SamsonTaxon/openmote-landing/assets/esp32-devkitc.webp

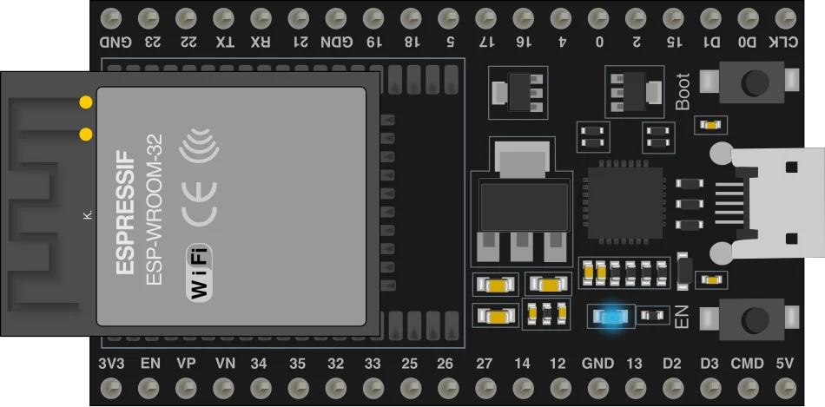
assets/esp32-devkitc.webp
