SamsonTaxon/openmote-landing/assets/photo-cutouts/product-01.png

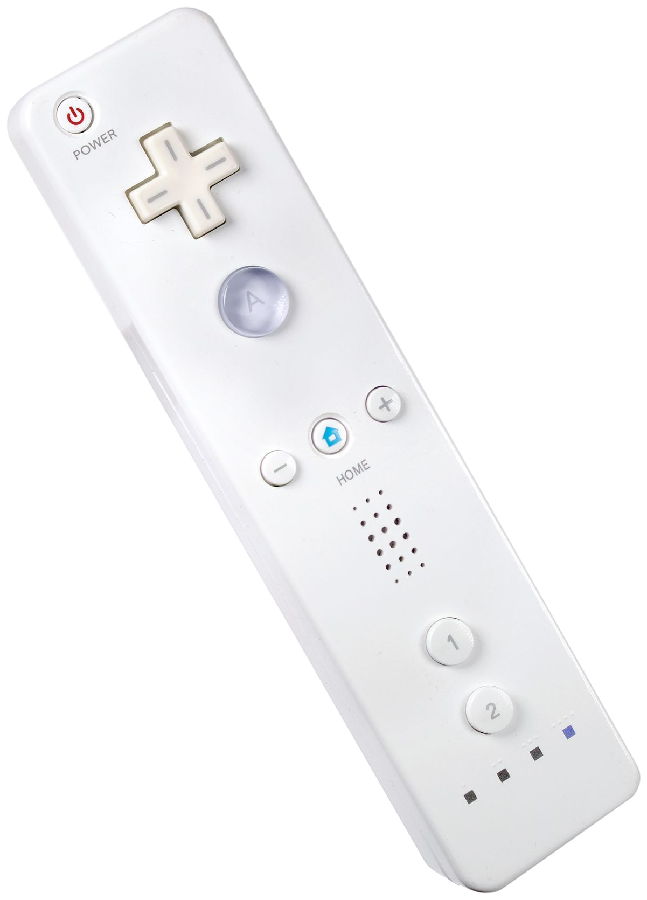
assets/photo-cutouts/product-01.png
