SamsonTaxon/openmote-landing/assets/photo-cutouts/product-02.png

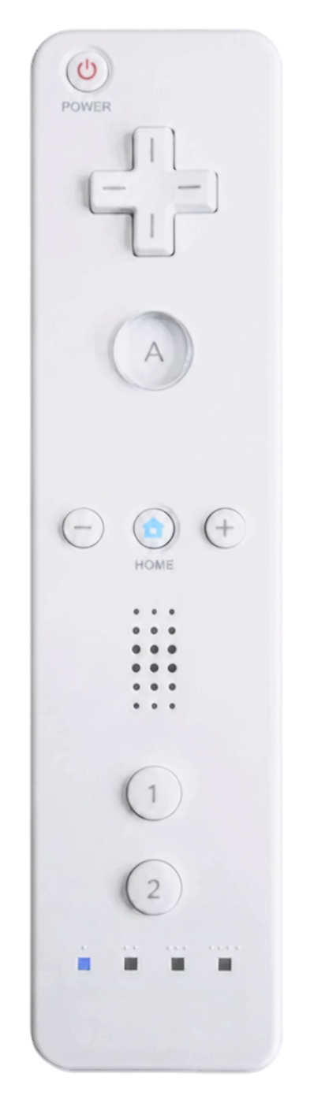
assets/photo-cutouts/product-02.png
