SamsonTaxon/openmote-landing/assets/photo-cutouts/product-03.png

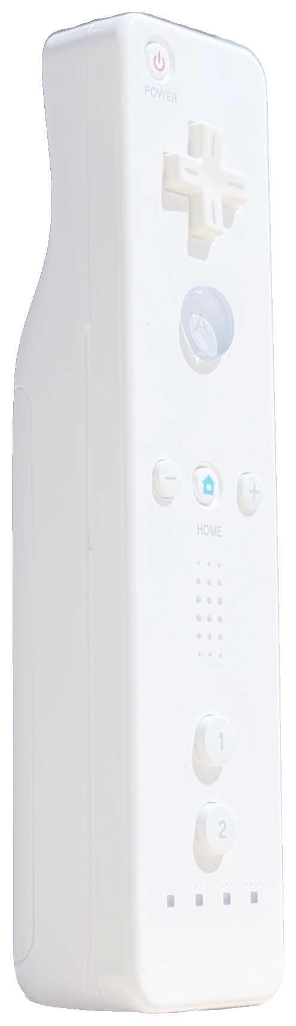
assets/photo-cutouts/product-03.png
