SamsonTaxon/openmote-landing/assets/photo-cutouts/product-03.webp

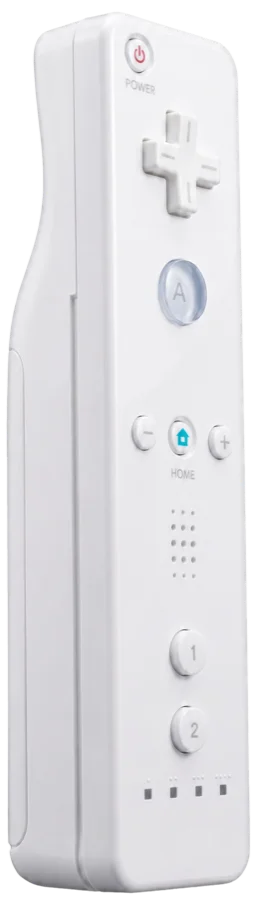
assets/photo-cutouts/product-03.webp
