SamsonTaxon/openmote-landing/assets/photo-cutouts/product-09-web.webp

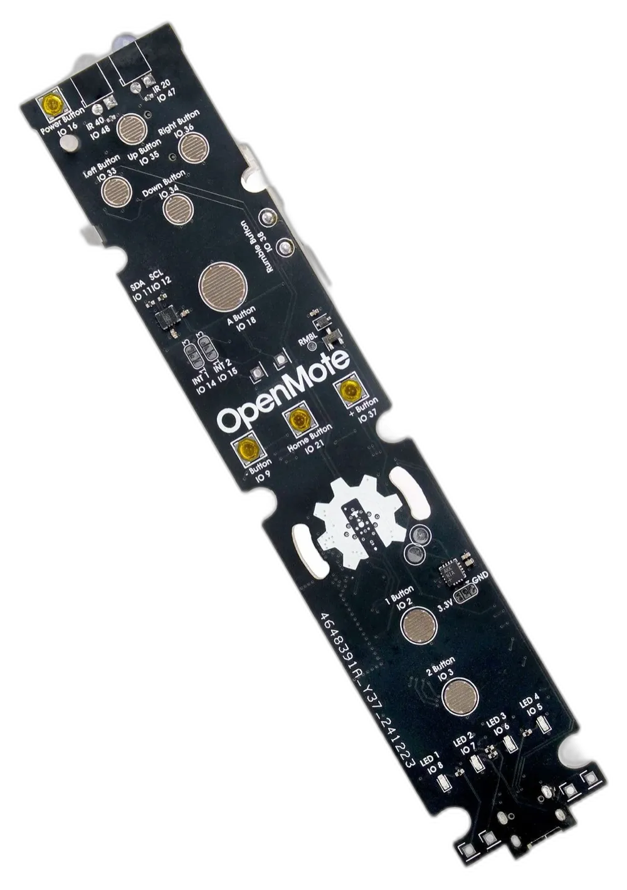
assets/photo-cutouts/product-09-web.webp
