SamsonTaxon/openmote-landing/assets/platform-circuitpython.webp

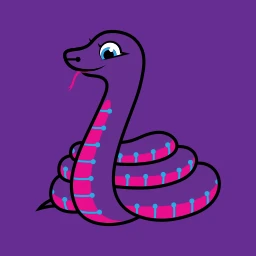
assets/platform-circuitpython.webp
