SamsonTaxon/openmote-landing/img/hero-remote-a.webp

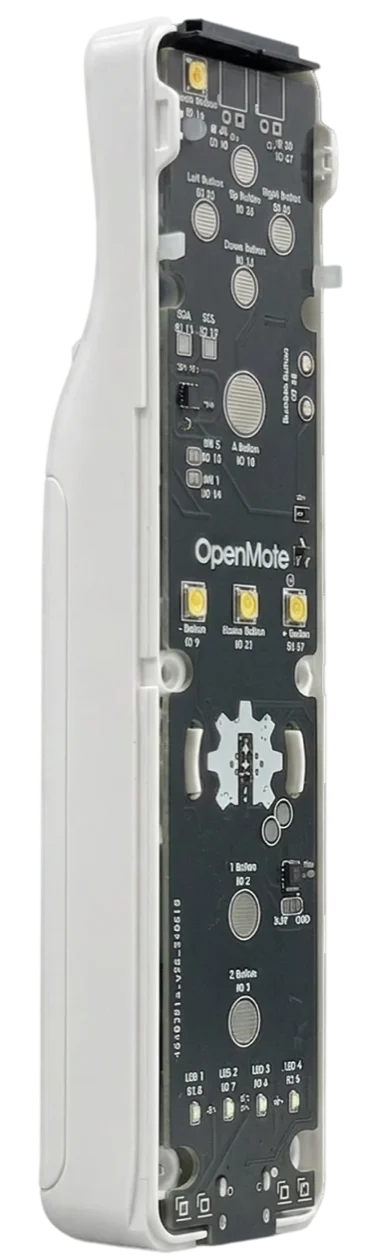
img/hero-remote-a.webp
