SamsonTaxon/openmote-landing/img/hero-remote-b.webp

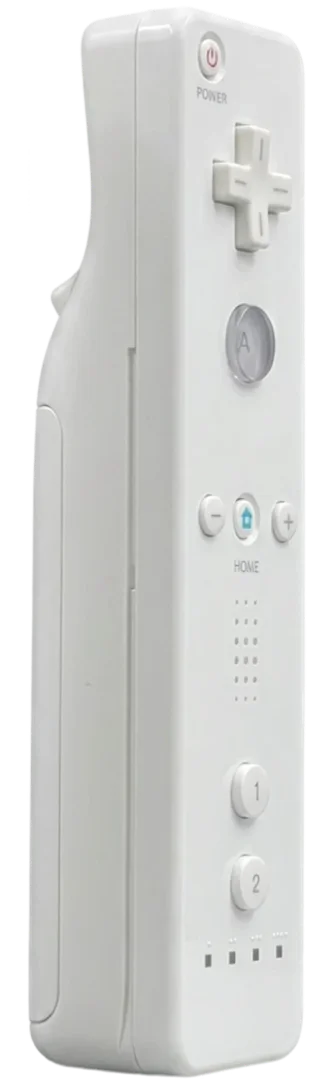
img/hero-remote-b.webp
