SamsonTaxon/openmote-landing/img/hero-remotes.webp

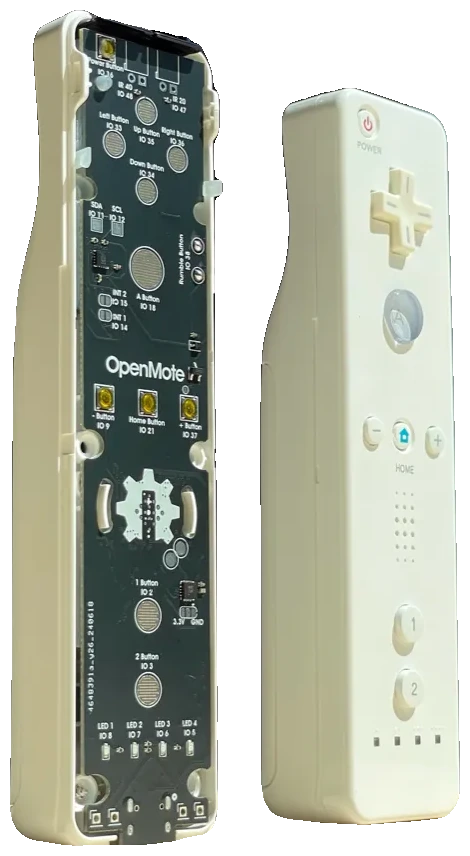
img/hero-remotes.webp
