SamsonTaxon/openmote-landing/img/hero.webp

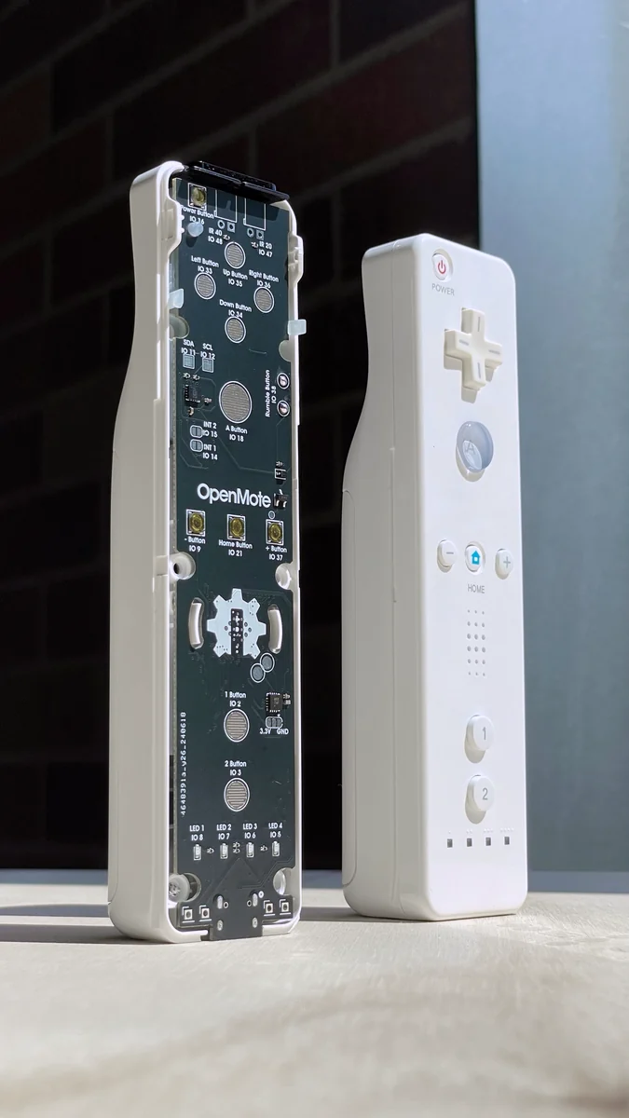
img/hero.webp
