SamsonTaxon/openmote-landing/img/og-openmote.jpg

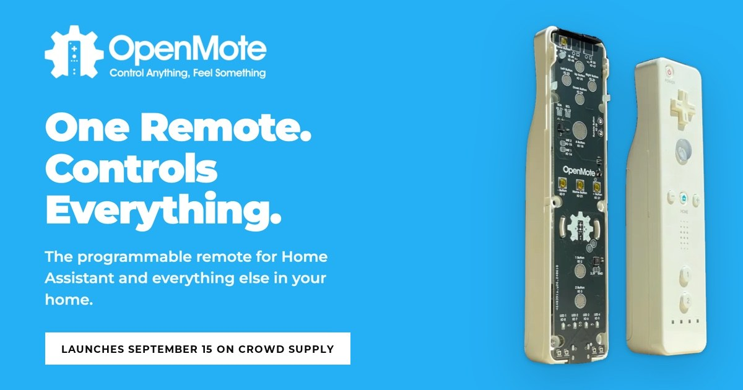
img/og-openmote.jpg
