SamsonTaxon/openmote-landing/img/openmote-1x1.jpg

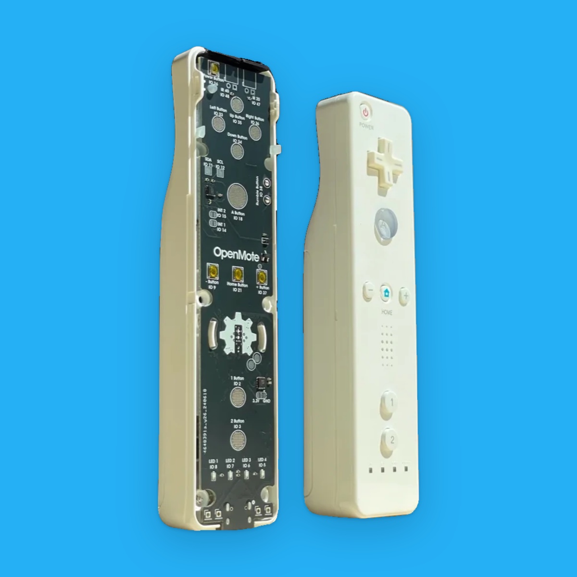
img/openmote-1x1.jpg
