SamsonTaxon/openmote-landing/img/openmote-4x3.jpg

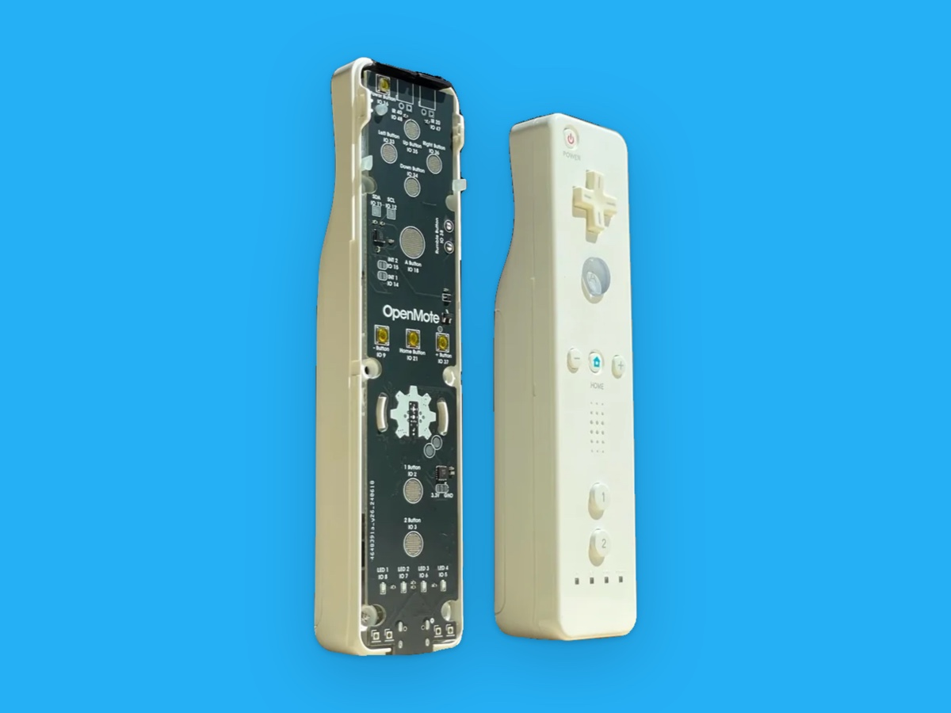
img/openmote-4x3.jpg
