SamsonTaxon/openmote-landing/img/openmote-16x9.jpg

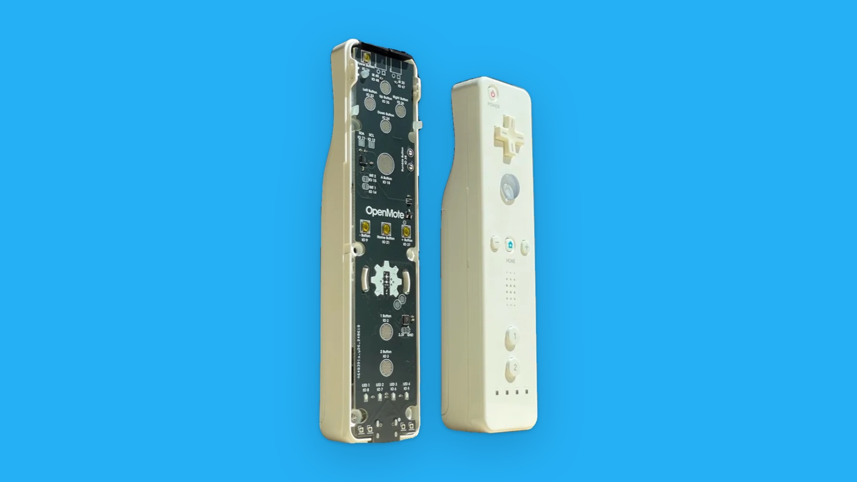
img/openmote-16x9.jpg
