SamsonTaxon/openmote-landing/img/openmote-board-1x1.jpg

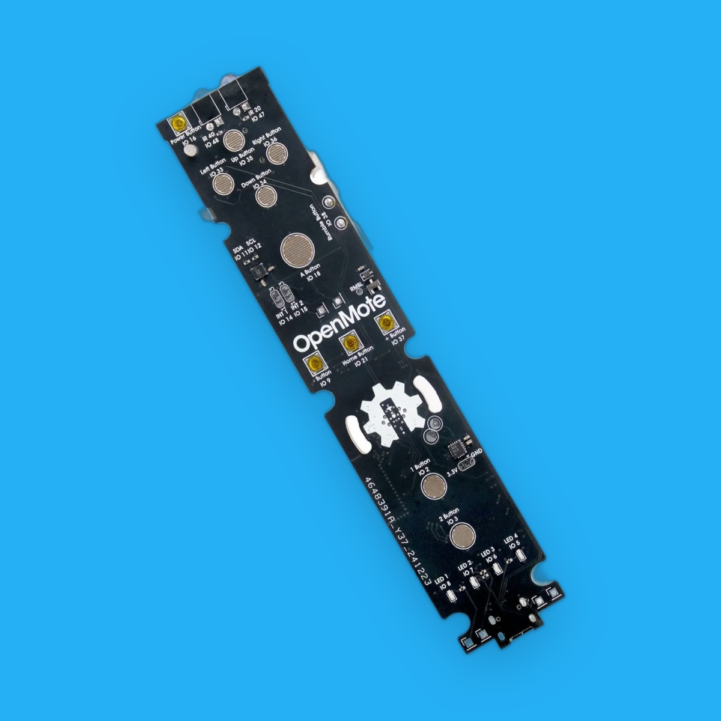
img/openmote-board-1x1.jpg
