SamsonTaxon/openmote-landing/img/openmote-board-4x3.jpg

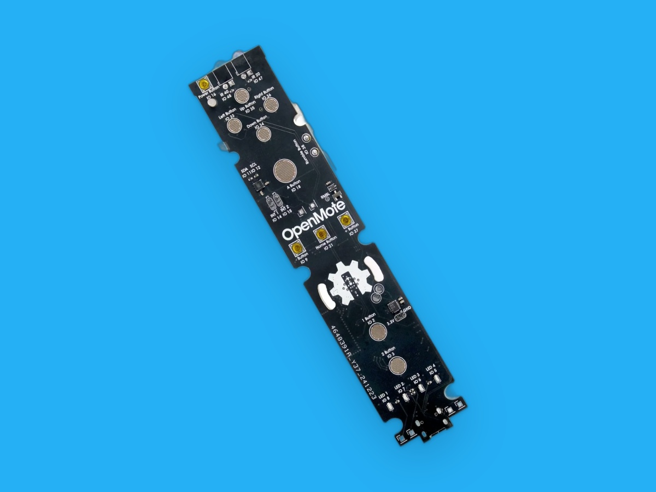
img/openmote-board-4x3.jpg
