SamsonTaxon/openmote-landing/img/showcase.png

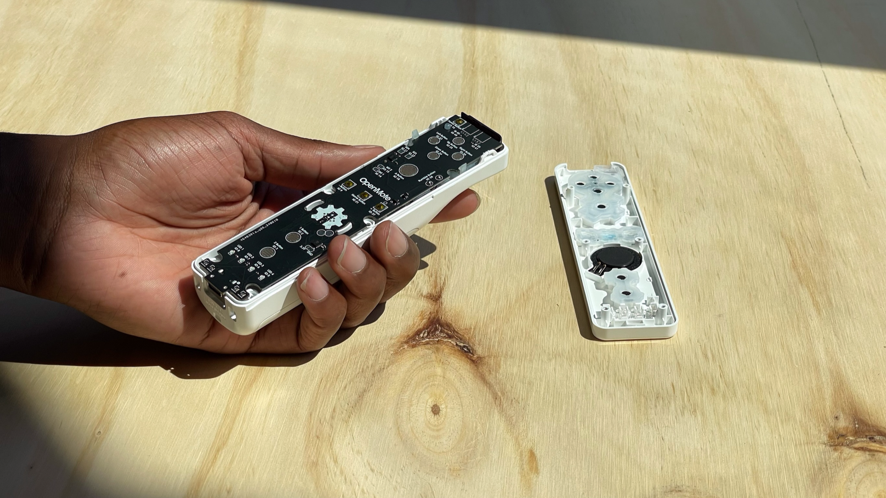
img/showcase.png
