SamsonTaxon/openmote-landing/img/showcase.webp

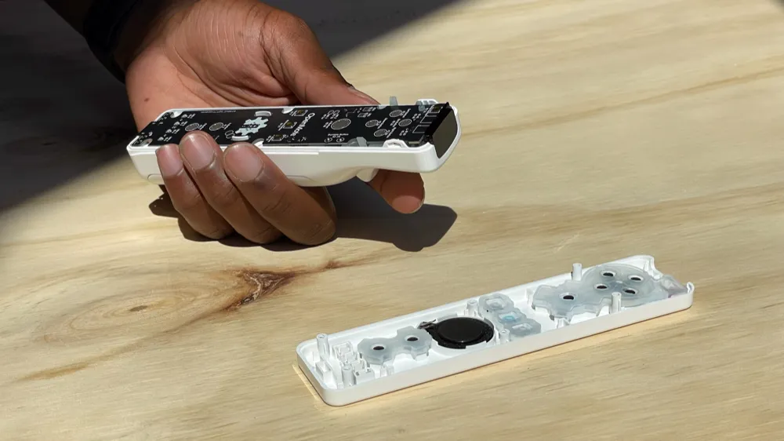
img/showcase.webp
