SamsonTaxon/openmote-landing/preview-b7k4x9/img/Group 22711 1.png

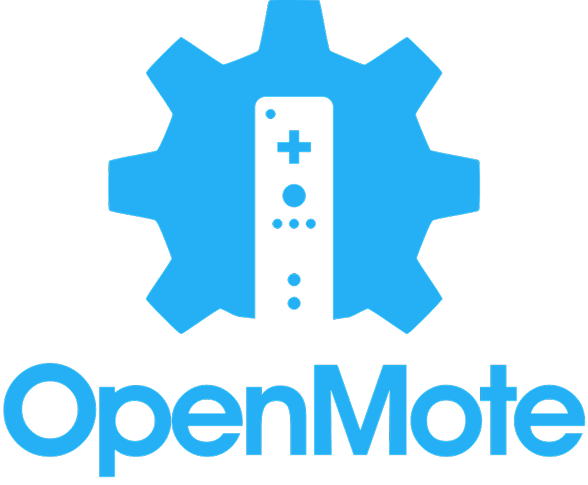
preview-b7k4x9/img/Group 22711 1.png
