SamsonTaxon/openmote-landing/preview-light-q7w2m5/img/arduino.webp

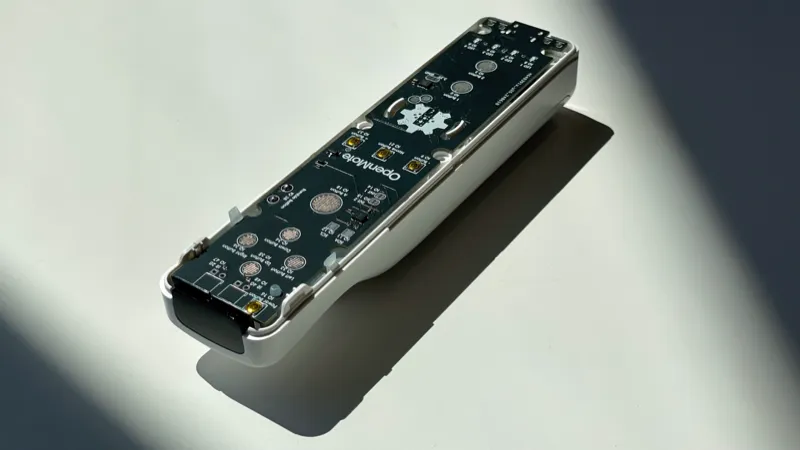
preview-light-q7w2m5/img/arduino.webp
