SamsonTaxon/openmote-landing/some assets/CS-images/openmote-back-01.jpg

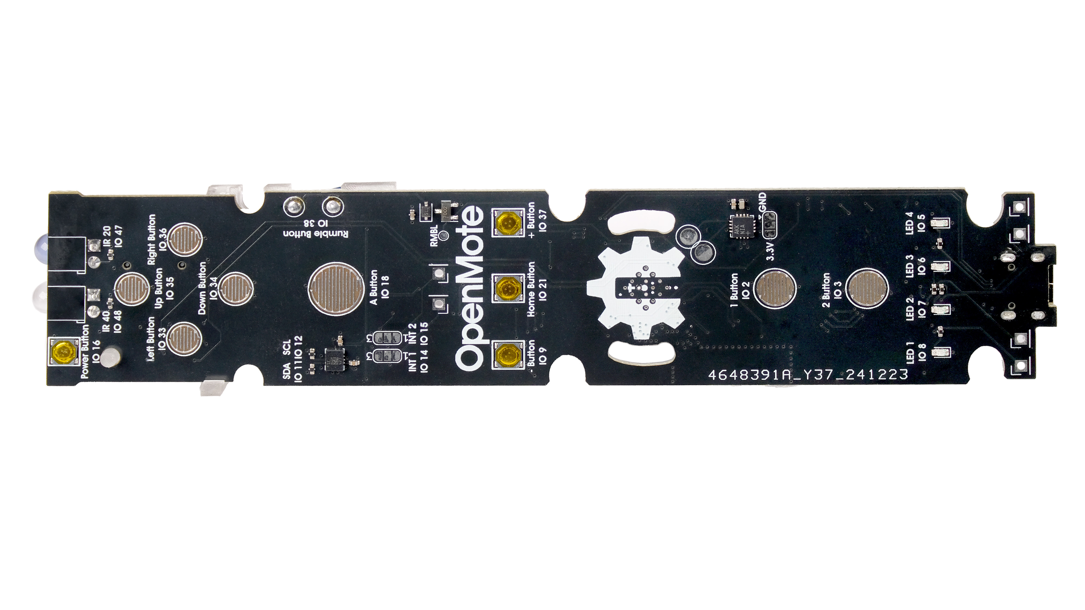
some assets/CS-images/openmote-back-01.jpg
