SamsonTaxon/openmote-landing/some assets/CS-images/openmote-battery-01.jpg

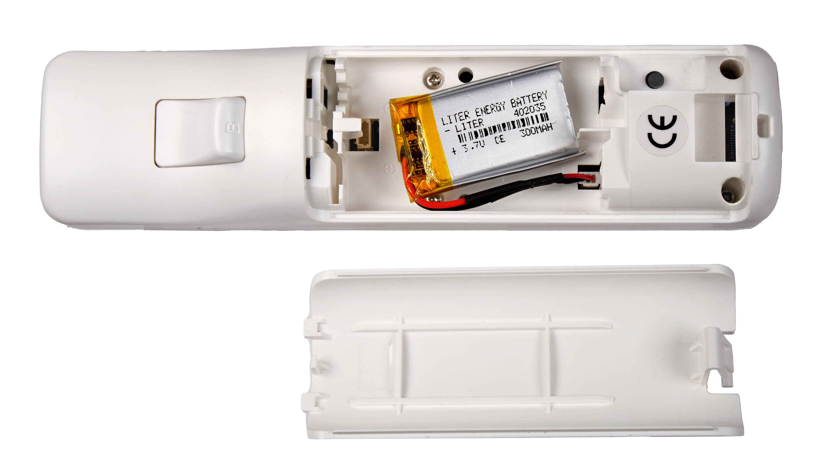
some assets/CS-images/openmote-battery-01.jpg
