SamsonTaxon/openmote-landing/some assets/CS-images/openmote-battery-usb-01.jpg

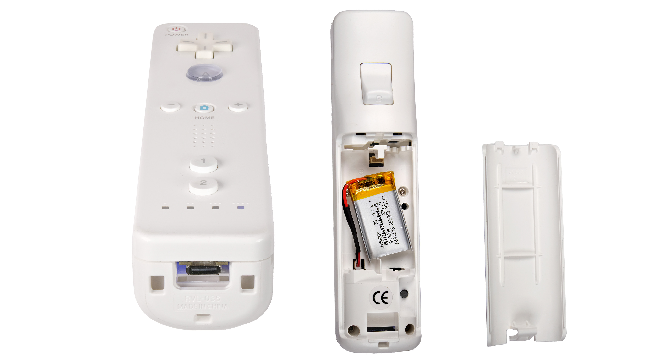
some assets/CS-images/openmote-battery-usb-01.jpg
