SamsonTaxon/openmote-landing/some assets/CS-images/openmote-front-01.jpg

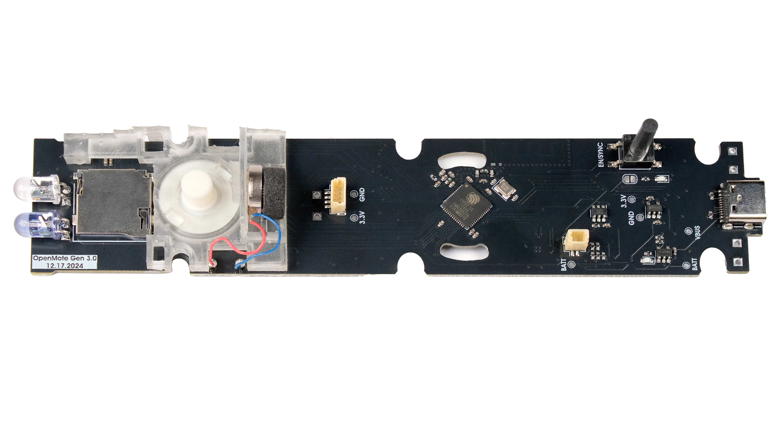
some assets/CS-images/openmote-front-01.jpg
