SamsonTaxon/openmote-landing/some assets/CS-images/openmote-front-back-01.jpg

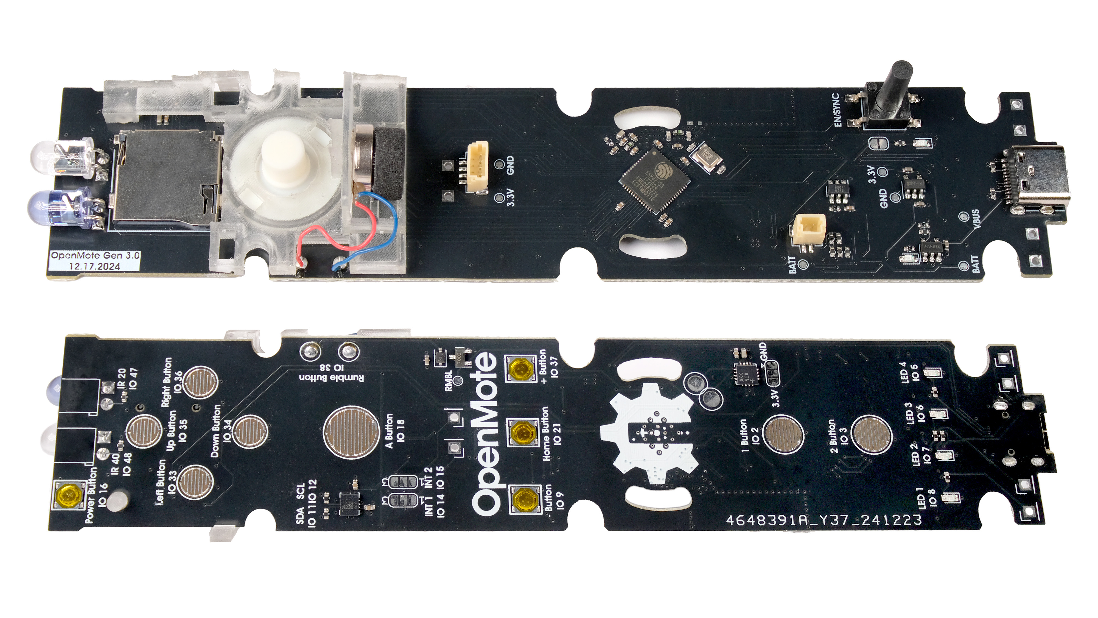
some assets/CS-images/openmote-front-back-01.jpg
