SamsonTaxon/openmote-landing/some assets/CS-images/openmote-pcb-back-01.jpg

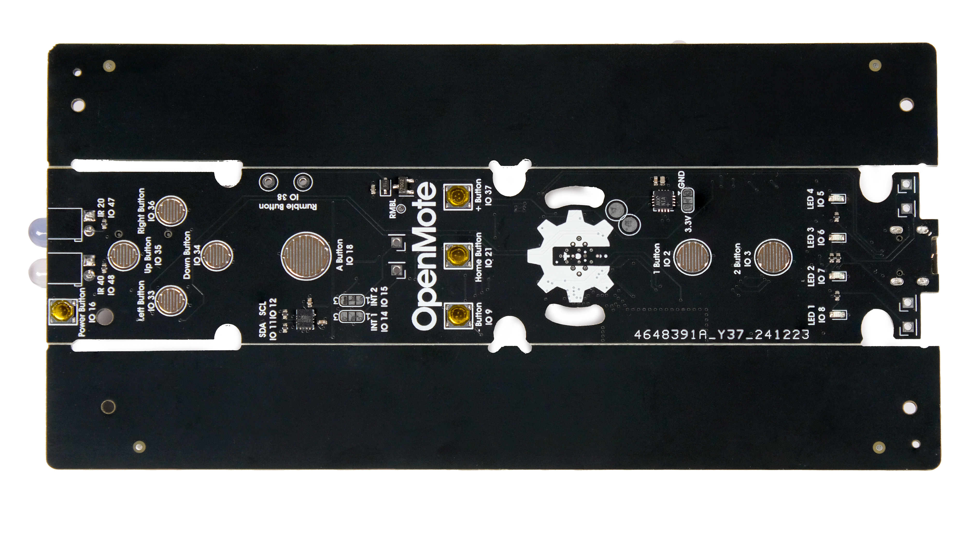
some assets/CS-images/openmote-pcb-back-01.jpg
