SamsonTaxon/openmote-landing/some assets/CS-images/openmote-pcb-front-01.jpg

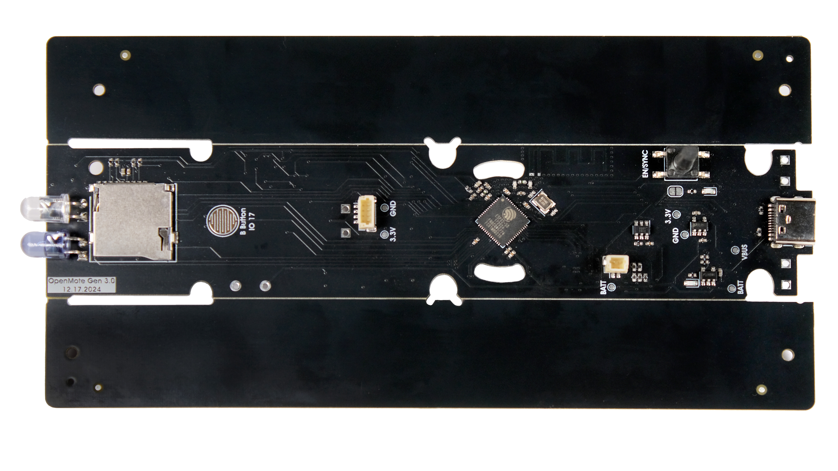
some assets/CS-images/openmote-pcb-front-01.jpg
