SamsonTaxon/openmote-landing/some assets/CS-images/openmote-pcb-front-back-01.jpg

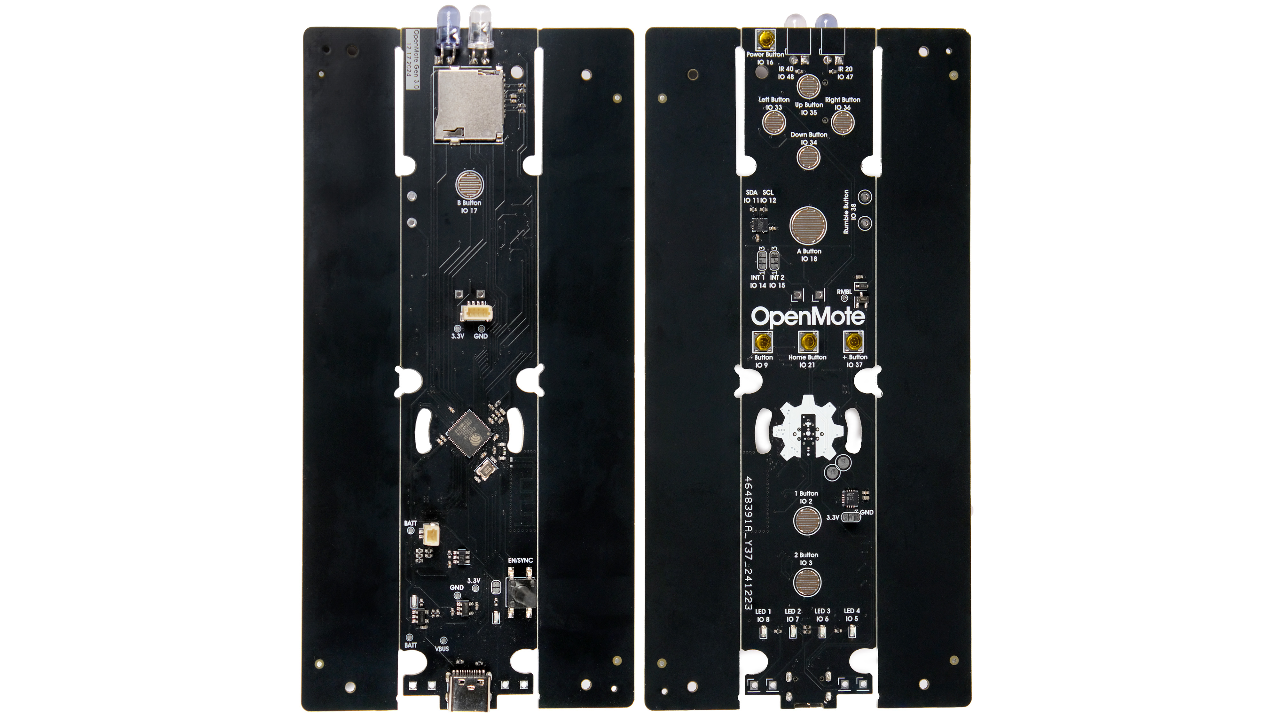
some assets/CS-images/openmote-pcb-front-back-01.jpg
