SamsonTaxon/openmote-landing/some assets/CS-images/openmote-side-by-side-01.jpg

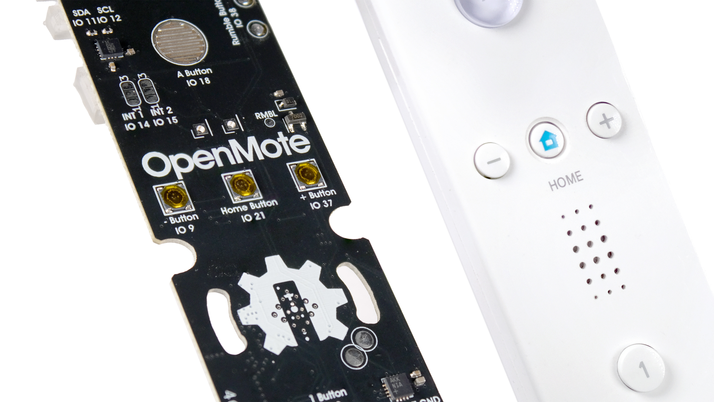
some assets/CS-images/openmote-side-by-side-01.jpg
