SamsonTaxon/openmote-landing/some assets/CS-images/openmote-side-by-side-02.jpg

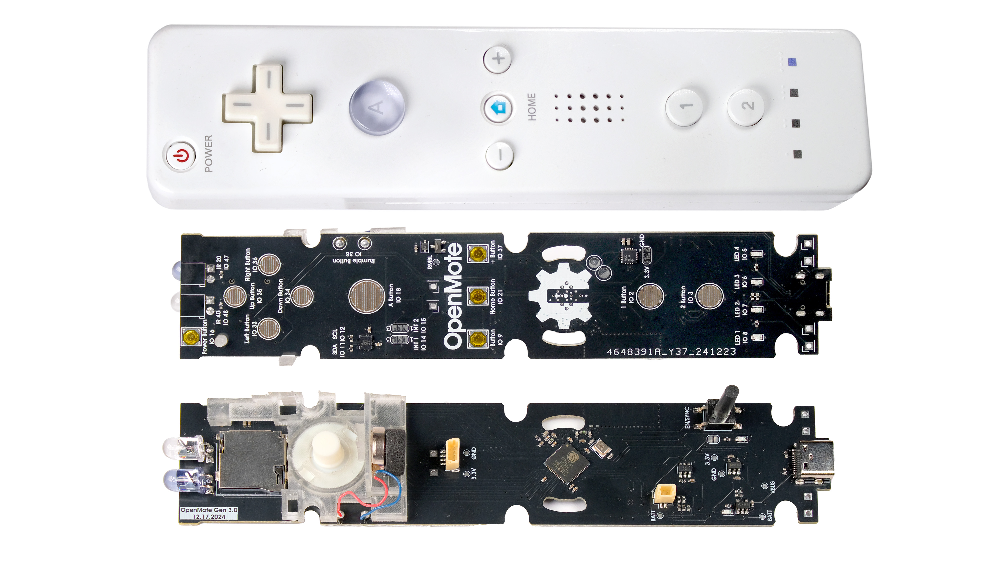
some assets/CS-images/openmote-side-by-side-02.jpg
