SamsonTaxon/openmote-landing/some assets/CS-images/openmote-side-by-side-03.jpg

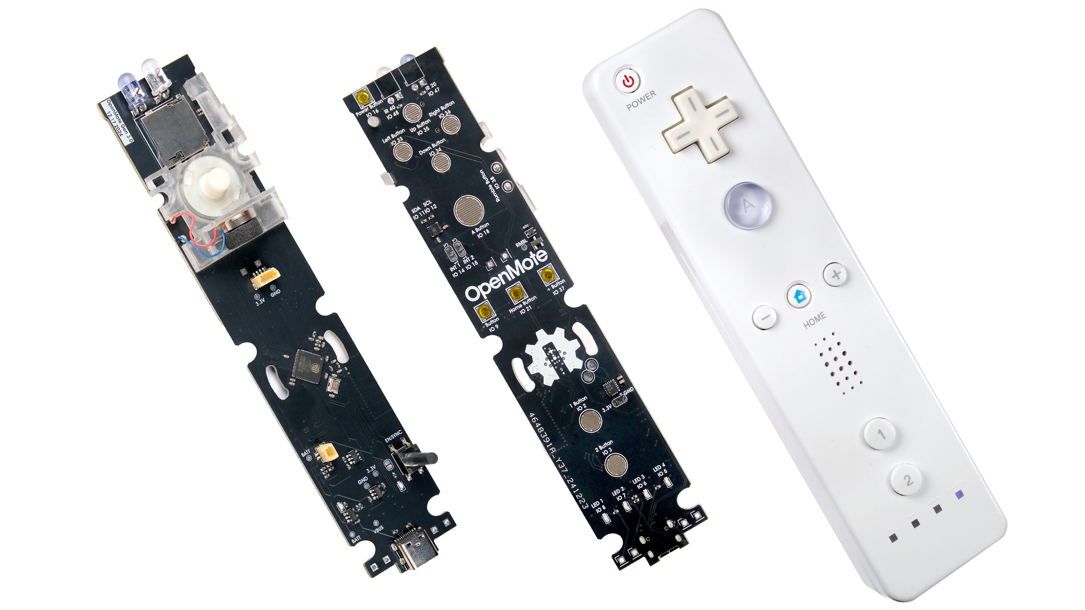
some assets/CS-images/openmote-side-by-side-03.jpg
