SamsonTaxon/openmote-landing/some assets/CS-images/openmote-usb-01.jpg

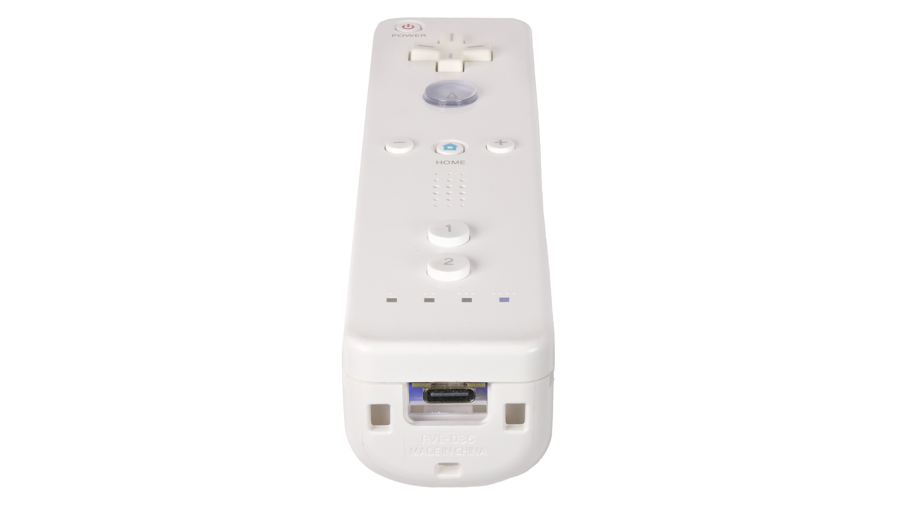
some assets/CS-images/openmote-usb-01.jpg
