SamsonTaxon/openmote-landing/some assets/Frame 14.png

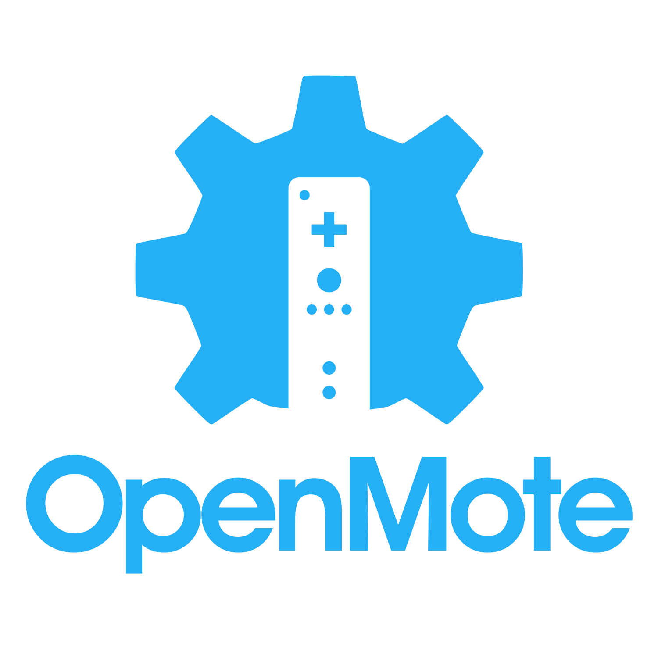
some assets/Frame 14.png
