SamsonTaxon/openmote-landing/some assets/Frame 15.png

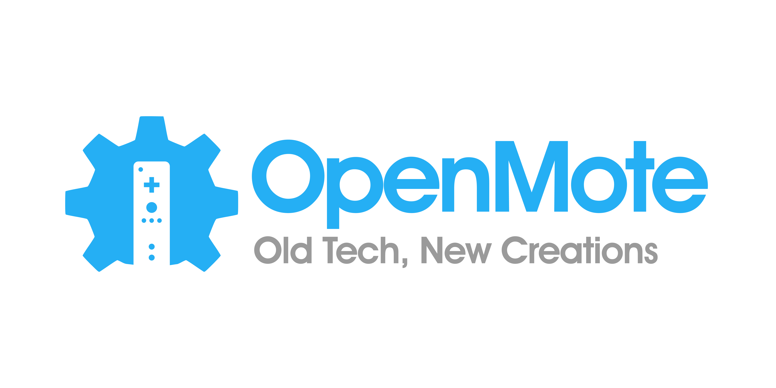
some assets/Frame 15.png
