SamsonTaxon/openmote-landing/some assets/IMG_0296.png

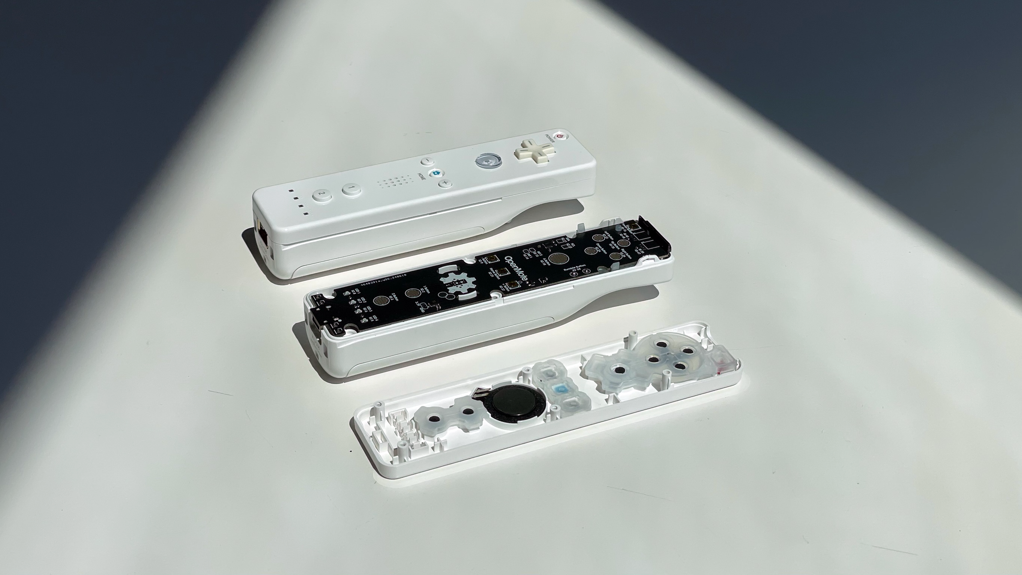
some assets/IMG_0296.png
