SamsonTaxon/openmote-landing/some assets/OpenMote Features.png

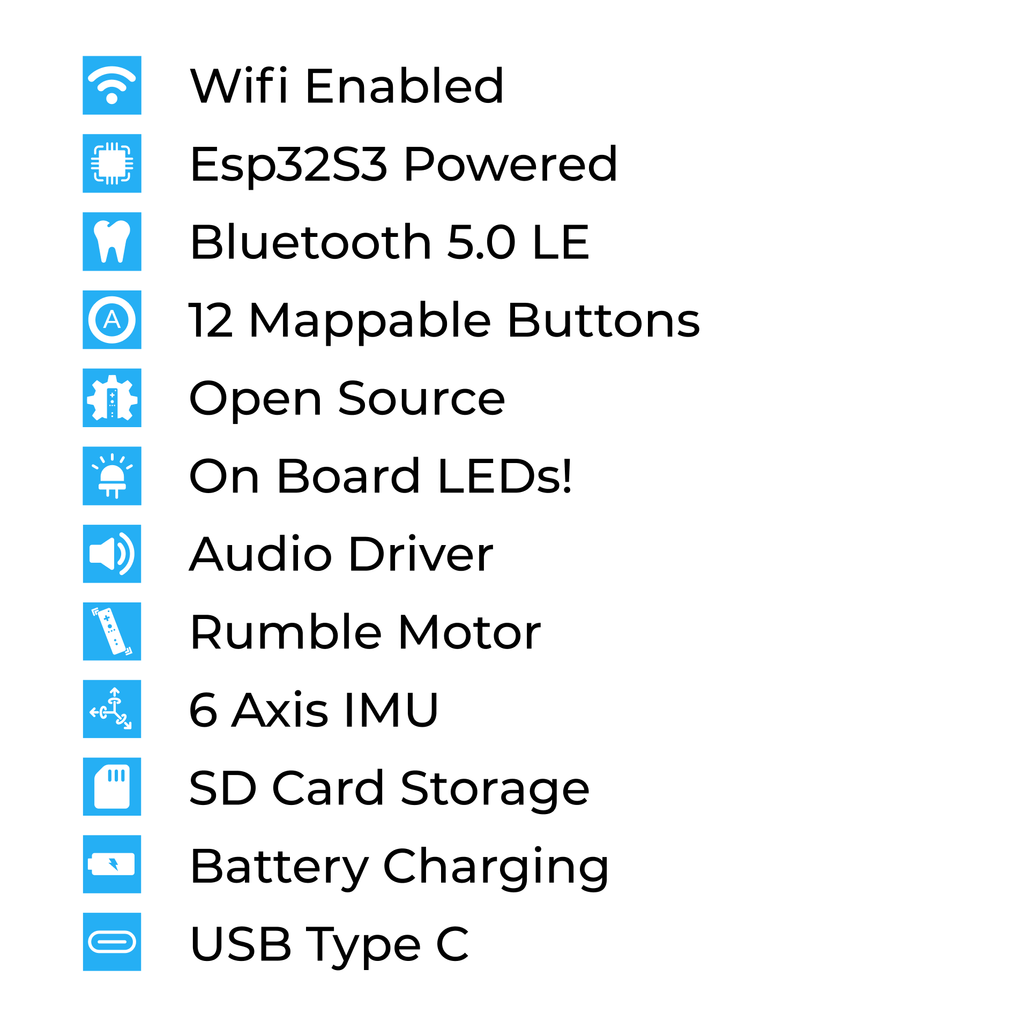
some assets/OpenMote Features.png
