SamsonTaxon/openmote-landing/some assets/openmote-hero-1x1.jpeg

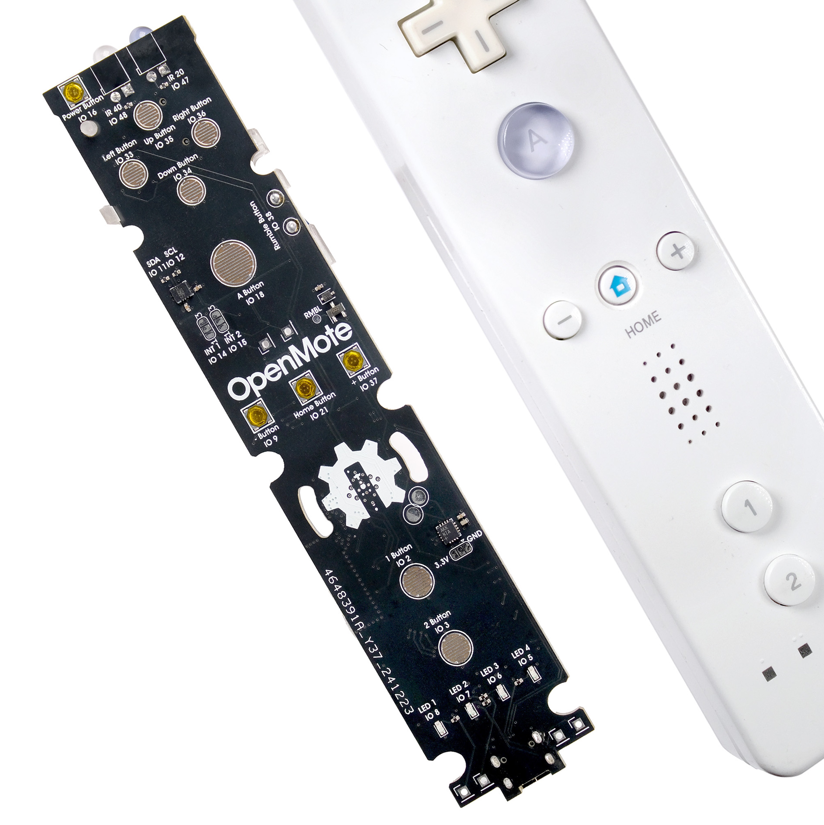
some assets/openmote-hero-1x1.jpeg
