SamsonTaxon/openmote-landing/some assets/openMote_evolution_fannedout_white.png

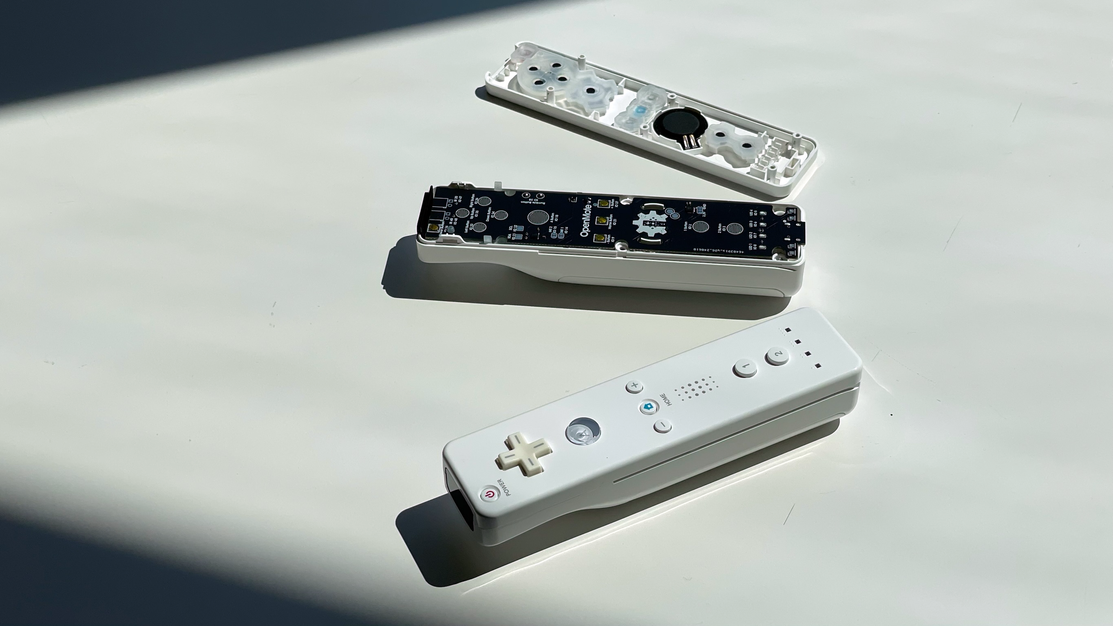
some assets/openMote_evolution_fannedout_white.png
