SamsonTaxon/openmote-landing/some assets/OpenMote_screenshot.png

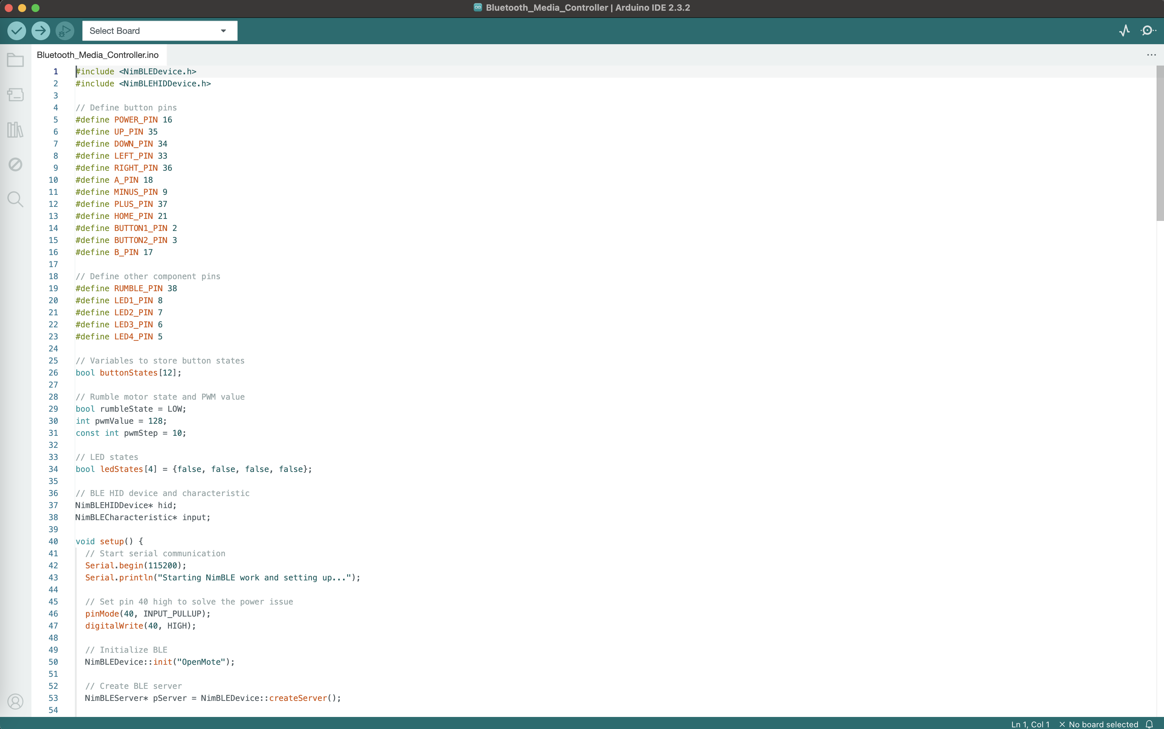
some assets/OpenMote_screenshot.png
