SamsonTaxon/openmote-landing/some assets/openMote_twin_naturebackground.png

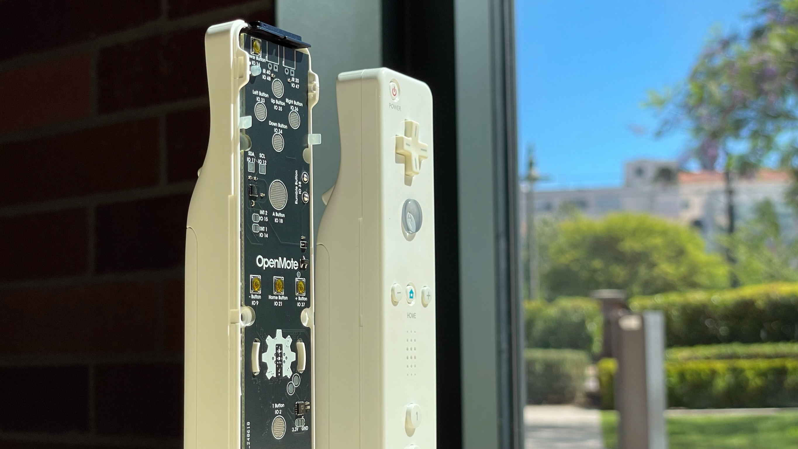
some assets/openMote_twin_naturebackground.png
