SamsonTaxon/openmote-landing/some assets/openMote_twin_wood_naturebackground.png

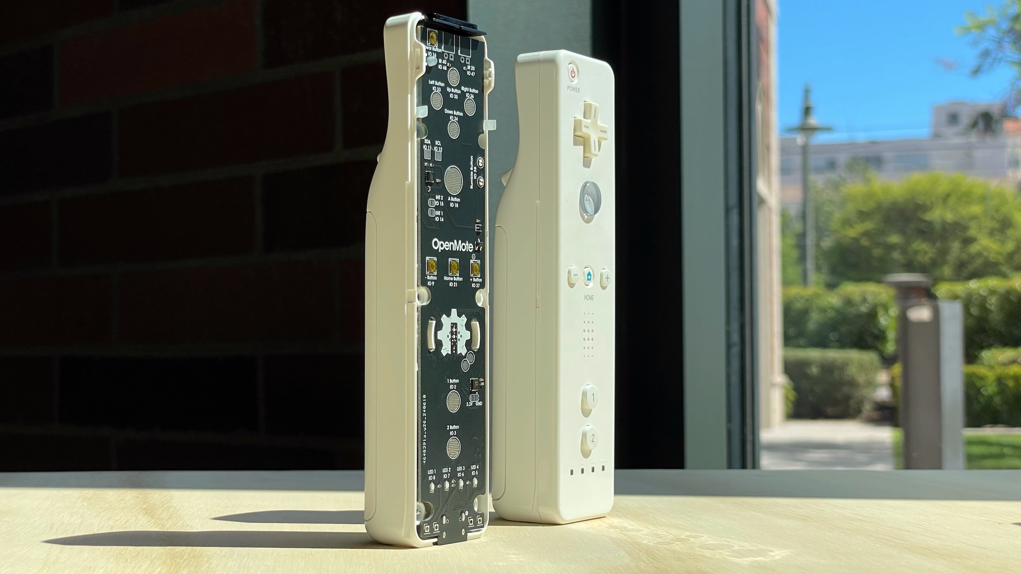
some assets/openMote_twin_wood_naturebackground.png
