SamsonTaxon/openmote-landing/some assets/SamsonTaxonHeadshot.png

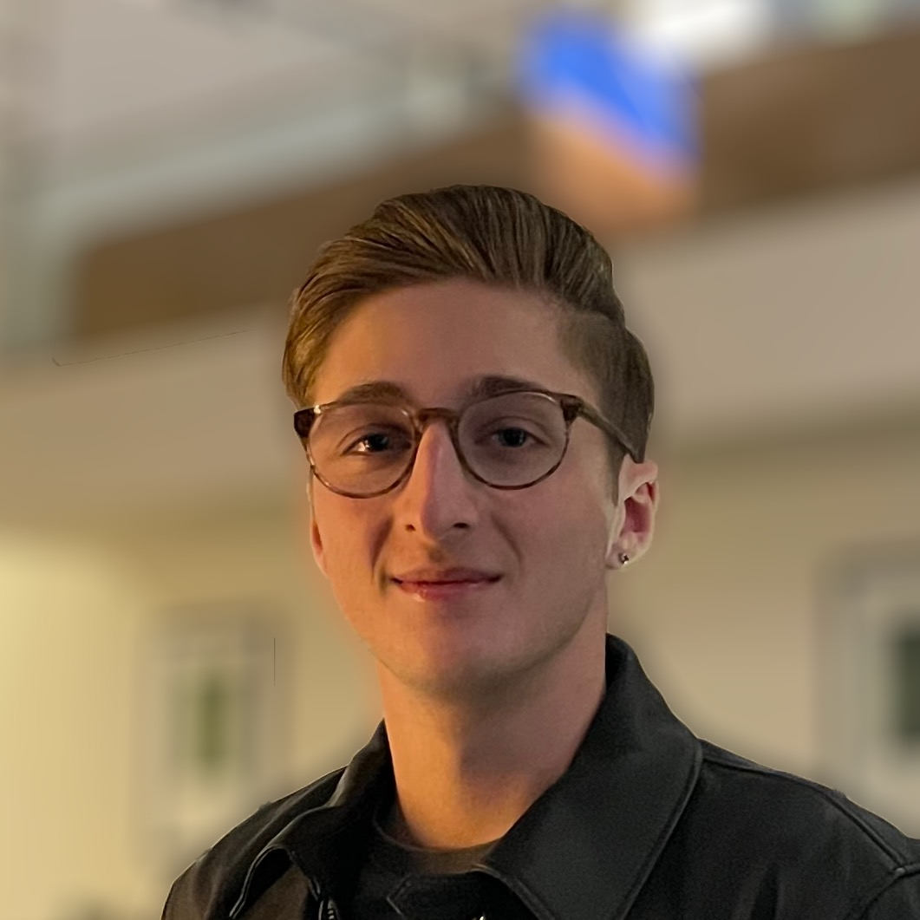
some assets/SamsonTaxonHeadshot.png
