SamsonTaxon/openmote-landing/untitled folder/cursor arrow.png

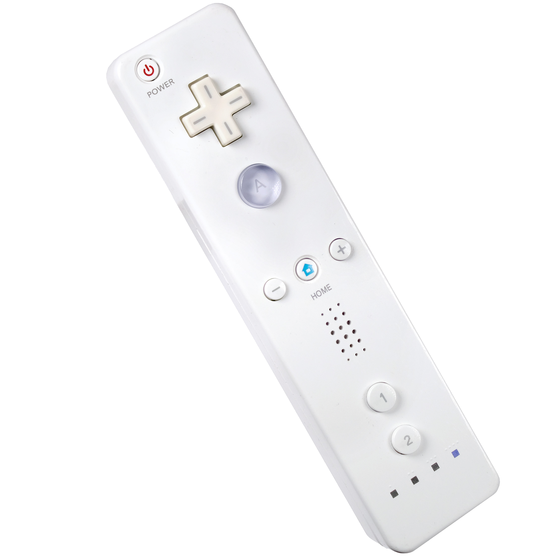
untitled folder/cursor arrow.png
