SamsonTaxon/openmote-landing/untitled folder/cursor finger.png

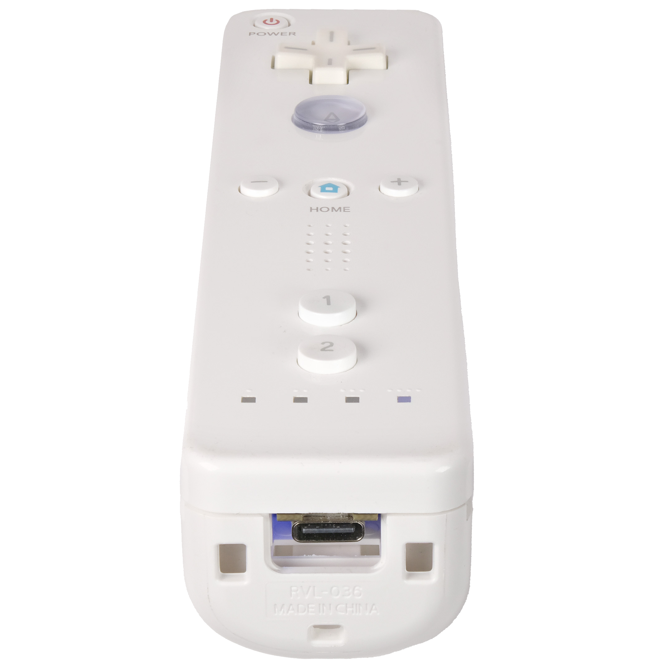
untitled folder/cursor finger.png
