SamsonTaxon/openmote-landing/guides/assembly/port-cover.stl

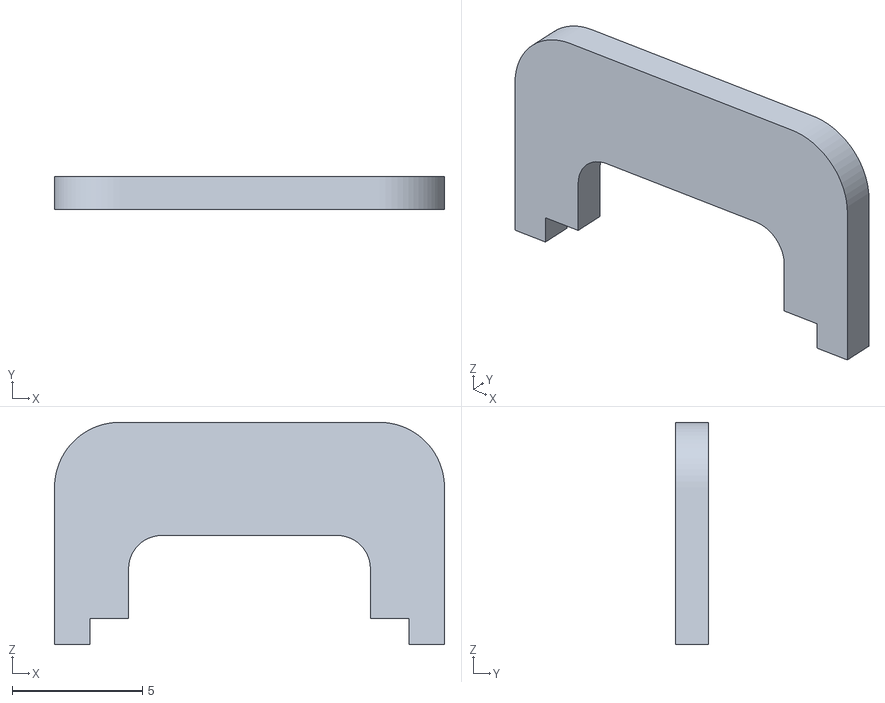
[picture p46: CAD file, 2026-10-07]
guides/assembly/port-cover.stl
15.0 x 1.25 x 8.55
