SamsonTaxon/openmote-landing/guides/index.html

Guides

Ask in the Discord (https://openmote.io/discord)

OpenMote

# Guides

Step by step, with a photo for every step. Mark steps done as you go, and ask in the Discord if you get stuck.

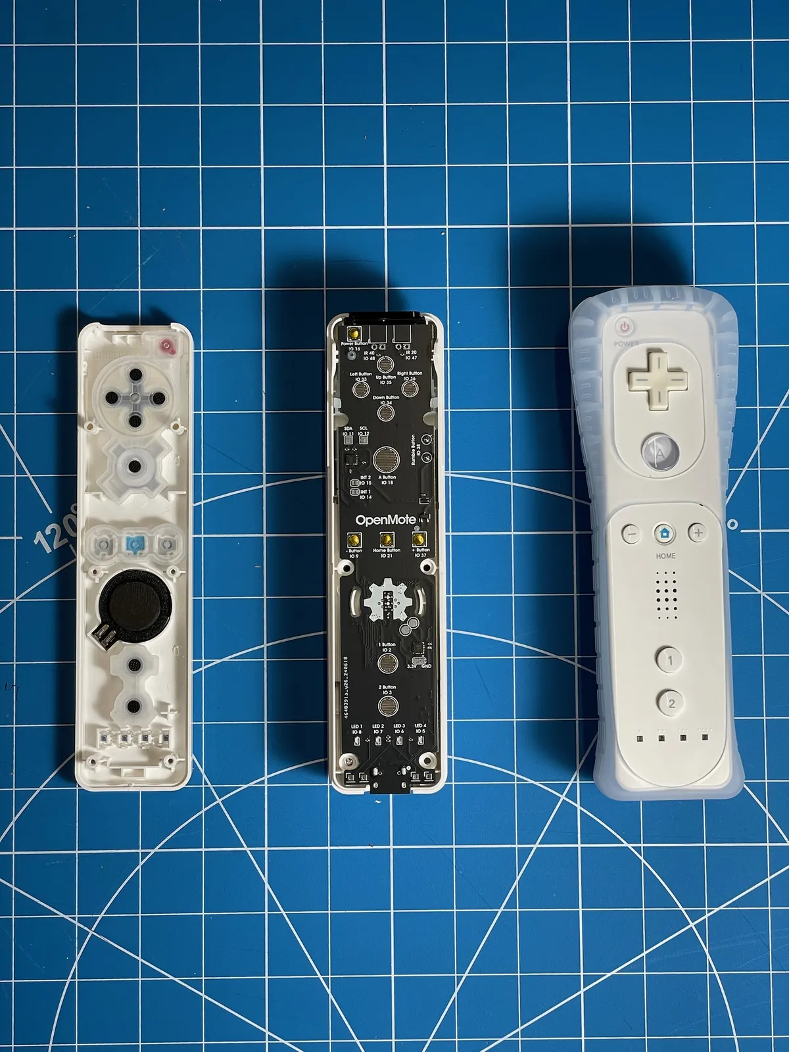
[picture p47: guides/assembly/photos/cover.webp]


Hardware

### Installing OpenMote in a Wiimote shell

14 steps, 5 to 15 minutes, no soldering. Open the shell, move the B trigger over, drop in the battery.

Coming soon

Setup

### First-time setup

Charging, connecting, and your first app.

Coming soon

Programming

### Programming OpenMote

Arduino IDE, the library, and the example apps.

© 2026 Hat & Hammer · Los Angeles

Wii and Wii Remote are trademarks of Nintendo. OpenMote is an independent product from Hat & Hammer and is not affiliated with, endorsed by, or sponsored by Nintendo.
