SamsonTaxon/openmote-landing/guides/assembly/index.html

Guides · Assembly

Step 1 of 14

Stuck and need help? (https://openmote.io/discord)

Heads up: We may update these steps as the kit changes.

Wiimote shell · Board replacement

# Installing OpenMote in a Wiimote shell

Swap the original Wii Remote board for an OpenMote. You will open the shell, move the B trigger over to a new bracket, and drop in a rechargeable battery. No soldering required.

DifficultyEasy

Steps14

Time5 to 15 min

Three stages side by side on a cutting mat: an open Wii Remote shell with its rubber button pads, a black OpenMote board sitting in a white shell, and a finished remote

Tools

01

Tri-wing screwdriver (Y1)For the four battery-bay screws

02

Opening pickPlastic, not metal. Releases the shell clips

Parts

01

OpenMote boardReplaces the original board

02

B trigger bracketHolds the B button over the board

03

3D printed port coverFills the gap around the USB-C port

04

Rechargeable lithium batteryReplaces the two AA batteries

The Guide

## Step by Step

Step1

### Remove the Battery Cover

Mark done

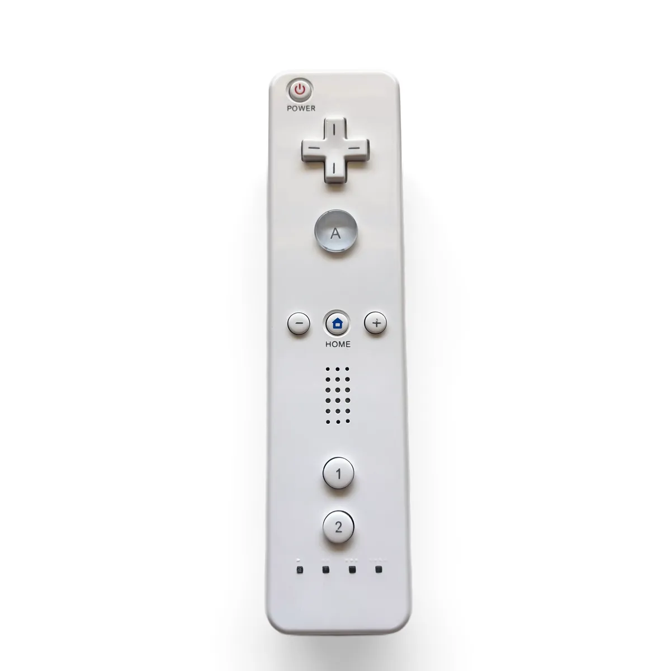
[picture p48: guides/assembly/photos/1484.webp]
Wii Remote face down on the mat with the wrist strap removed, B trigger facing up


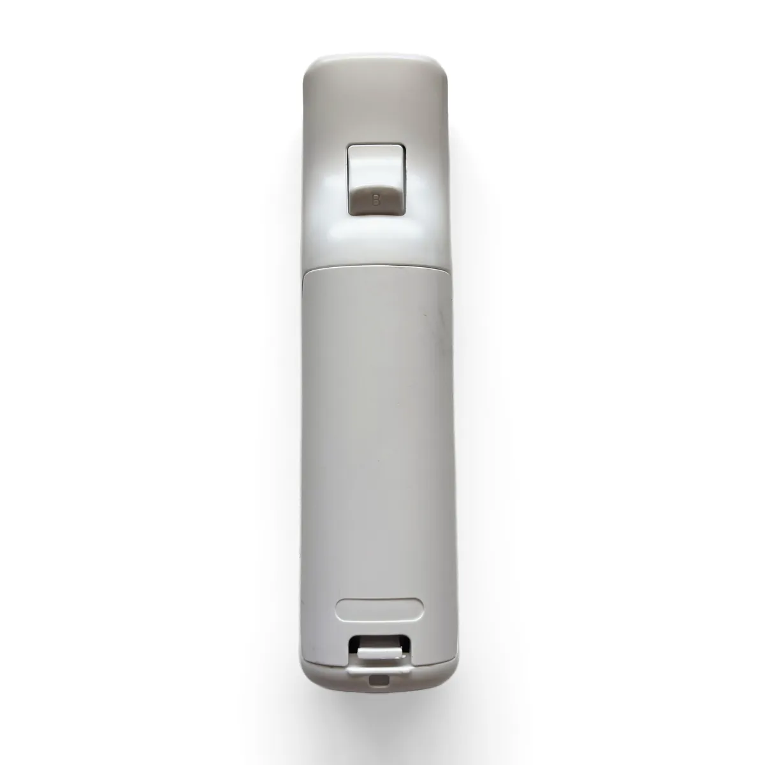
[picture p49: guides/assembly/photos/1485.webp]
Thumb pressing the tab on the battery cover to slide it off


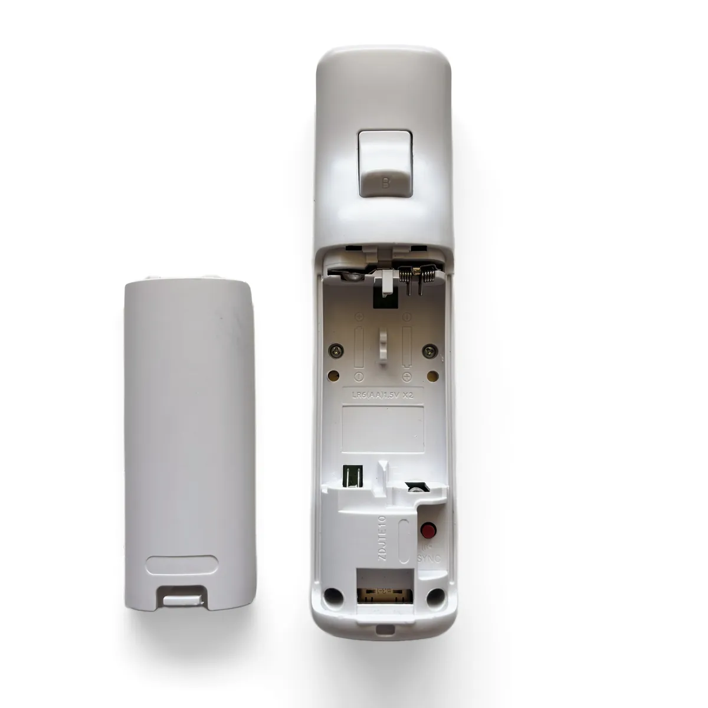
[picture p50: guides/assembly/photos/1486.webp]
Battery cover off and the two AA batteries lifted out of the bay


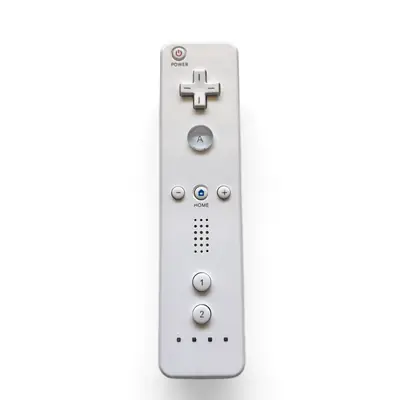
[picture p51: guides/assembly/photos/1484-t.webp]
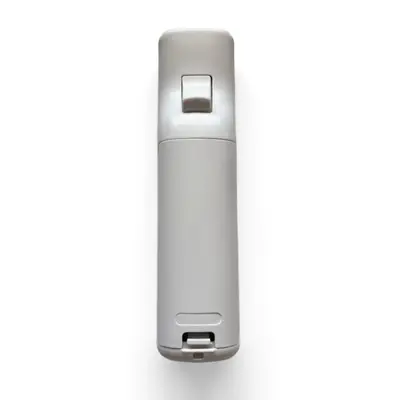
[picture p52: guides/assembly/photos/1485-t.webp]
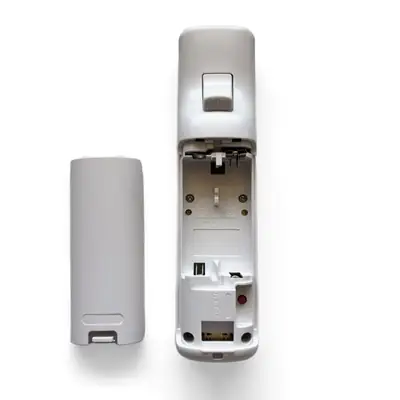
[picture p53: guides/assembly/photos/1486-t.webp]
  

- Remove the wrist strap and any silicone jacket from the Wii Remote.
- Flip the remote over so the B trigger faces up.
- Press the tab at the bottom of the battery cover and slide it off.
- Take out both AA batteries. The OpenMote runs on its own rechargeable cell, so you won’t need them again.
- Done, next: Remove the Tri-Wing Screws →

Step2

### Remove the Tri-Wing Screws

Mark done

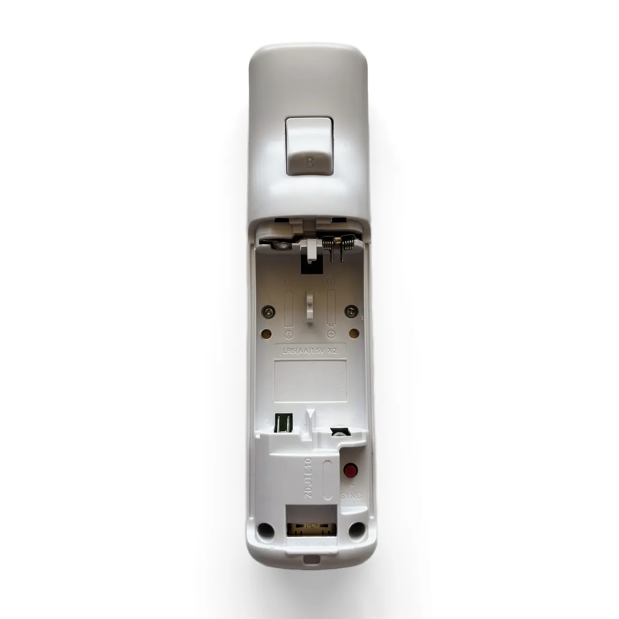
[picture p54: guides/assembly/photos/1487.webp]
Open battery bay with the four tri-wing screws circled in red, two at the top and two at the bottom


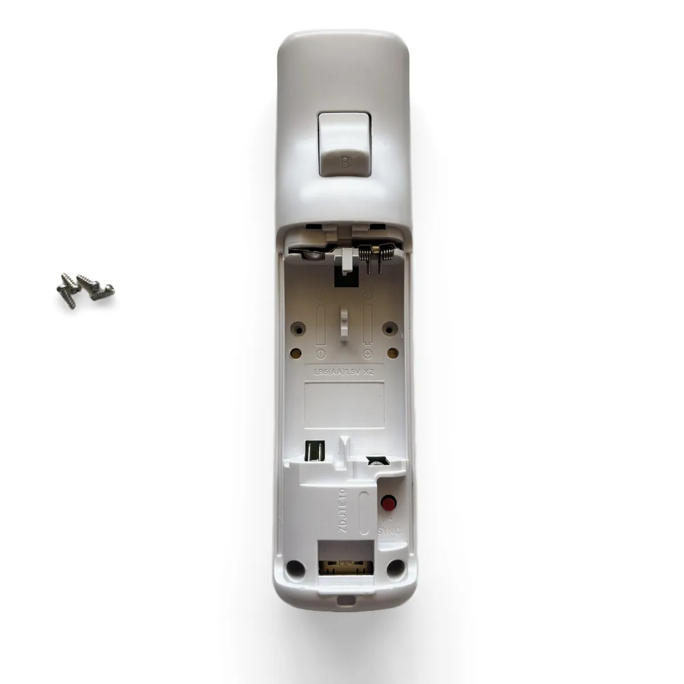
[picture p55: guides/assembly/photos/1488.webp]
Tri-wing screwdriver removing one of the screws inside the battery bay


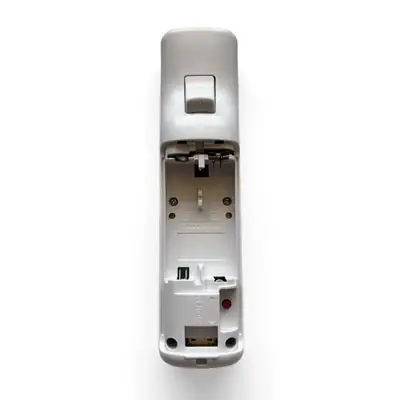
[picture p56: guides/assembly/photos/1487-t.webp]
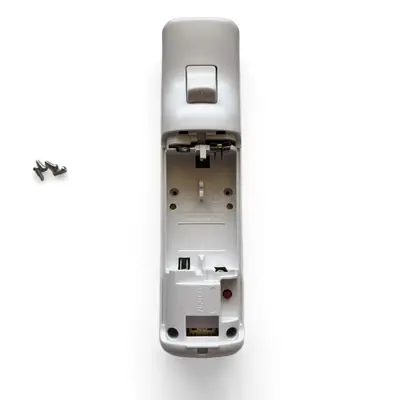
[picture p57: guides/assembly/photos/1488-t.webp]
 

- Remove the four Y1 tri-wing screws inside the battery bay, two near the top, two at the bottom.
- Note: Keep the screws together. You’ll reuse all four in Step 12.
- Done, next: Release the Shell Clips →

Step3

### Release the Shell Clips

Mark done

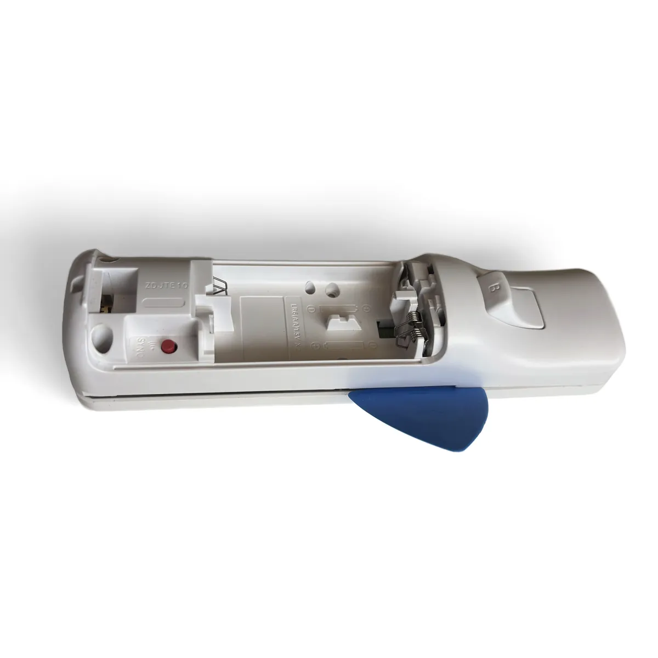
[picture p58: guides/assembly/photos/1489.webp]
Blue opening pick pushed into the seam near the battery bay, with an arrow pointing along the seam toward the trigger end


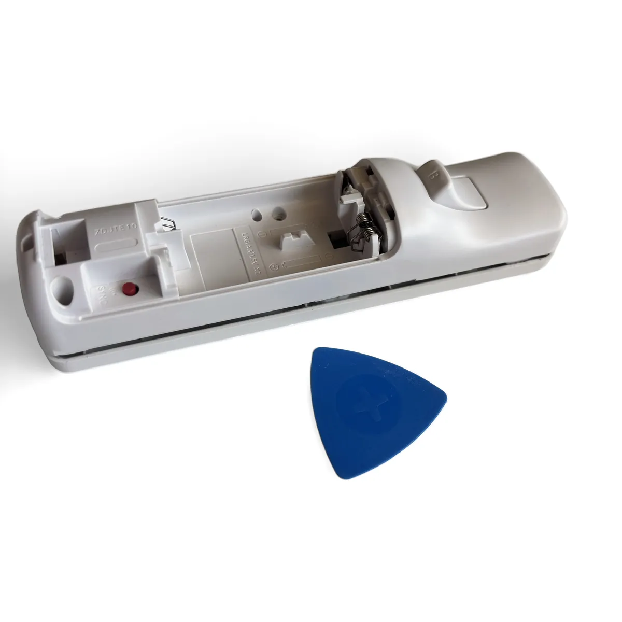
[picture p59: guides/assembly/photos/1490.webp]
Pick held upright in the seam while the other hand holds the remote


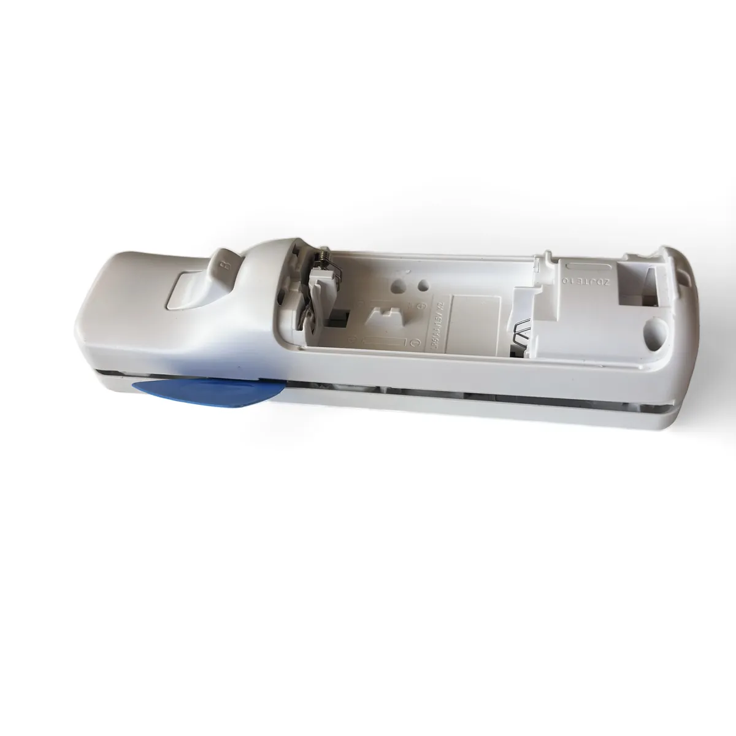
[picture p60: guides/assembly/photos/1491.webp]
Pick sliding along the seam, the two shells starting to separate


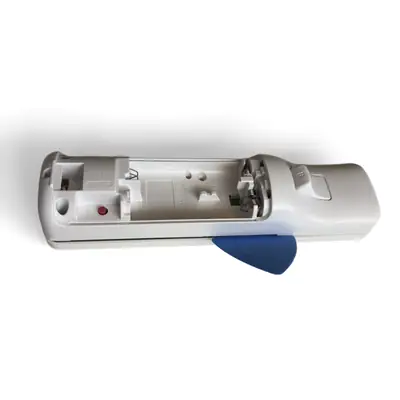
[picture p61: guides/assembly/photos/1489-t.webp]
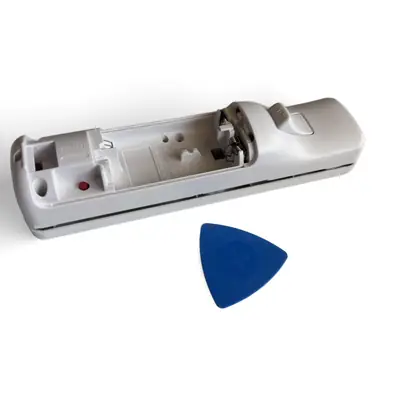
[picture p62: guides/assembly/photos/1490-t.webp]
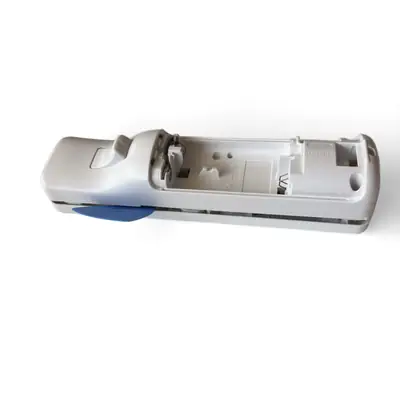
[picture p63: guides/assembly/photos/1491-t.webp]
  

- Insert an opening pick into the seam between the top and bottom shells, near the battery bay.
- Push the pick straight down into the seam, pointing toward the bottom shell. Don’t hold it flat or at an angle.
- Note: Pointing the pick down pushes the clips apart instead of prying against them, so they release without breaking.
- Slide the pick along the seam toward the trigger end, in the direction of the arrow, to release the clips. Work down one side, then the other.
- Caution: Go slowly around the trigger. The clips there are short and can snap if you twist the pick.
- Done, next: Separate the Shells →

Step4

### Separate the Shells

Mark done

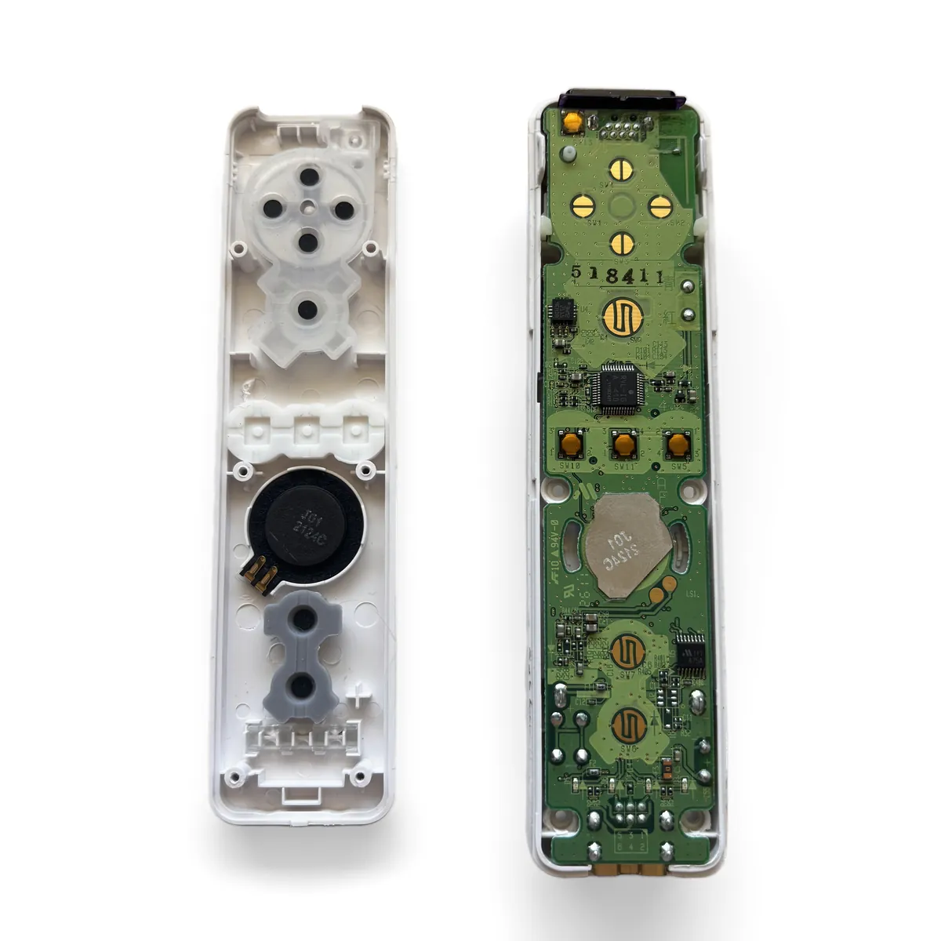
[picture p64: guides/assembly/photos/1493.webp]
Top shell lifted away and set face down beside the bottom shell with the original board still seated


- Lift the top shell straight up and set it face-down beside the bottom shell.
- Caution: Keep the top shell’s button side facing the table as you lift it. If you flip it over, the loose buttons and membranes will fall out.
- The original board stays seated in the bottom shell. The rubber button membranes and speaker stay in the top shell.
- Done, next: Lift Out the Original Board →

Step5

### Lift Out the Original Board

Mark done

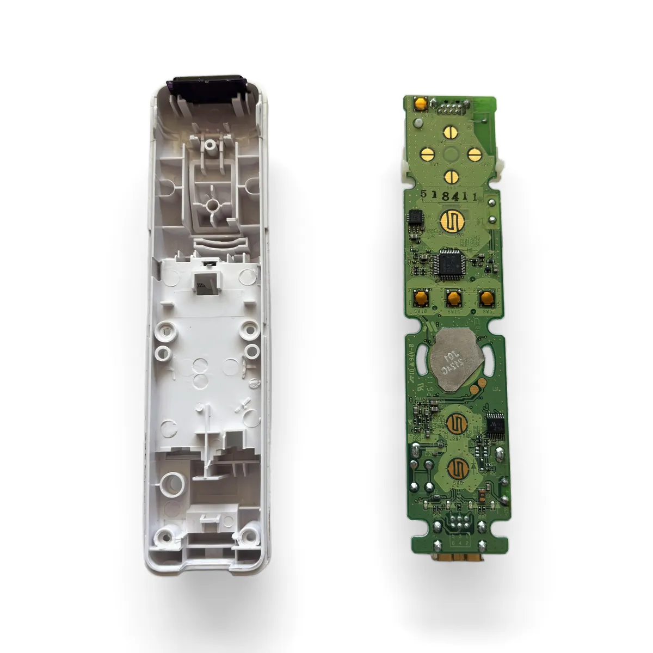
[picture p65: guides/assembly/photos/1494.webp]
Original Wii Remote board lifted out of the bottom shell by its edges, B trigger assembly attached underneath


- Grip the board by its edges and lift it out of the bottom shell.
- The B trigger assembly comes out attached to the underside of the board.
- Done, next: Check the Top Shell →

Step6

### Check the Top Shell

Mark done

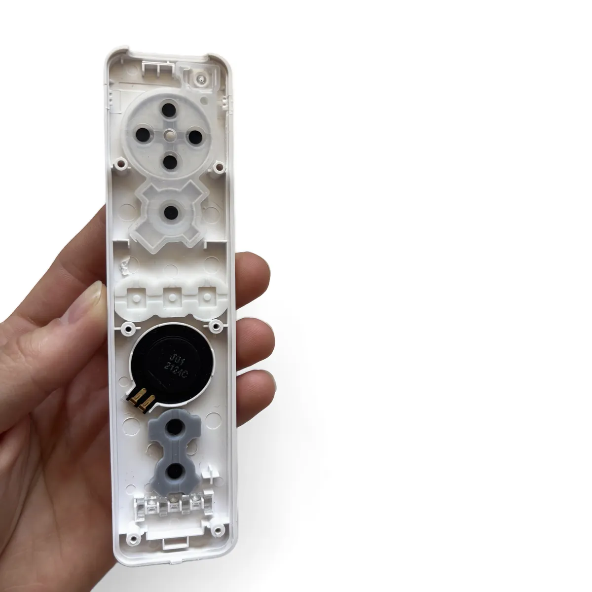
[picture p66: guides/assembly/photos/1507.webp]
Inside of the empty top shell showing the rubber button membranes and the speaker


- Make sure every rubber button membrane is seated flat in the top shell.
- Note: A membrane that has shifted will make its button feel mushy or not register at all.
- Done, next: Seat the OpenMote Board →

Step7

### Seat the OpenMote Board

Mark done

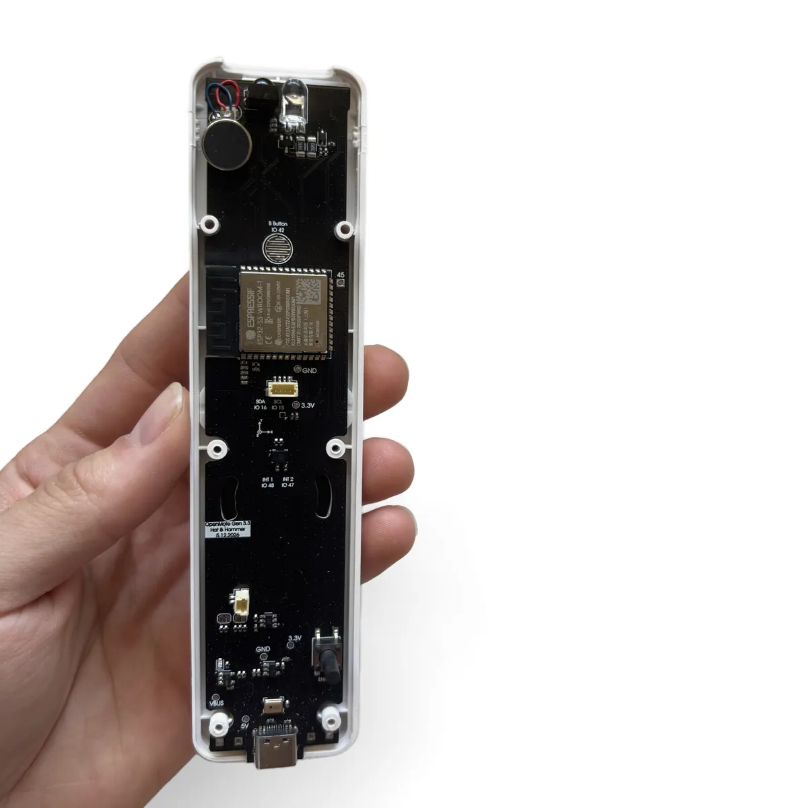
[picture p67: guides/assembly/photos/1512.webp]
OpenMote board in the top shell with the six mounting holes circled in yellow over the shell posts


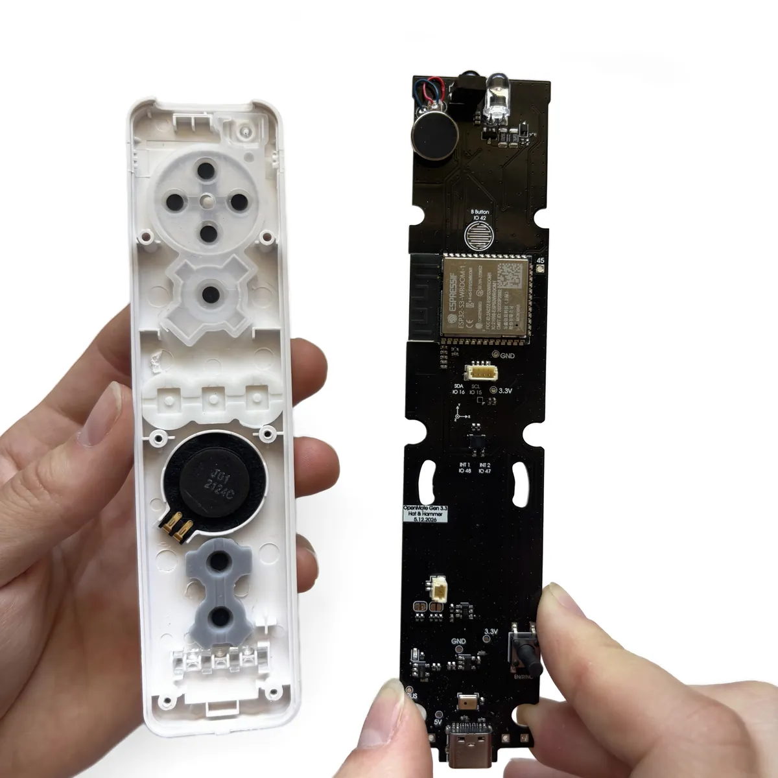
[picture p68: guides/assembly/photos/1513.webp]
OpenMote board being lowered into the top shell, USB-C port at the bottom end


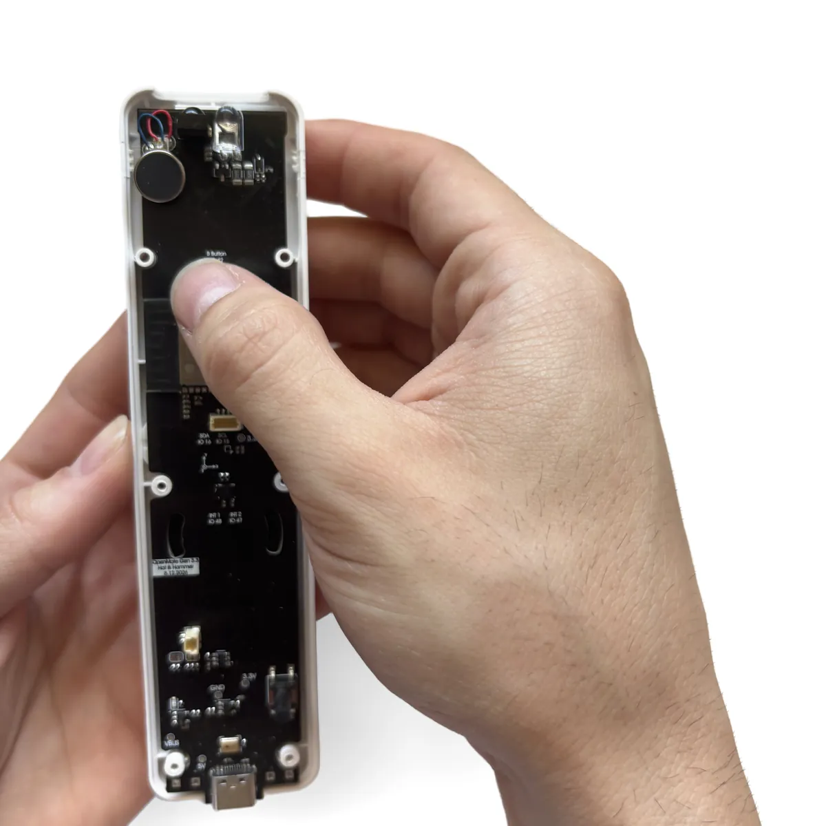
[picture p69: guides/assembly/photos/1511.webp]
OpenMote board resting flat on the button membranes inside the top shell


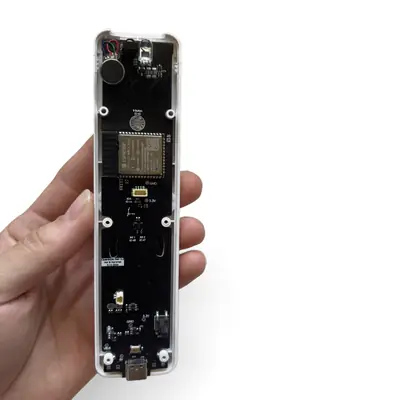
[picture p70: guides/assembly/photos/1512-t.webp]
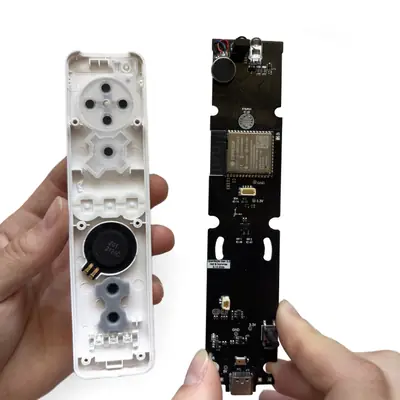
[picture p71: guides/assembly/photos/1513-t.webp]
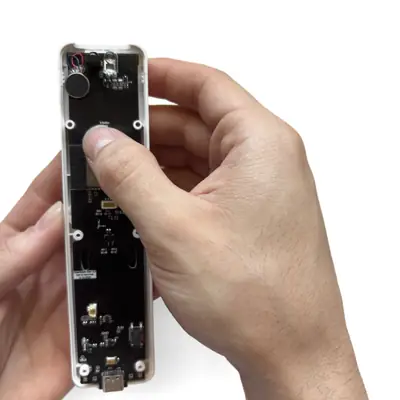
[picture p72: guides/assembly/photos/1511-t.webp]
  

- Line up the OpenMote board with the top shell, USB-C port at the bottom end.
- Lower the board in and press gently along its length until it sits flat on the membranes.
- Alignment: Line up the six holes on the board with the posts in the shell, circled in yellow.
- Note: The board should drop in without force. If it rocks, lift it out and re-check the membranes.
- Done, next: Fit the B Trigger Bracket →

Step8

### Fit the B Trigger Bracket

Mark done

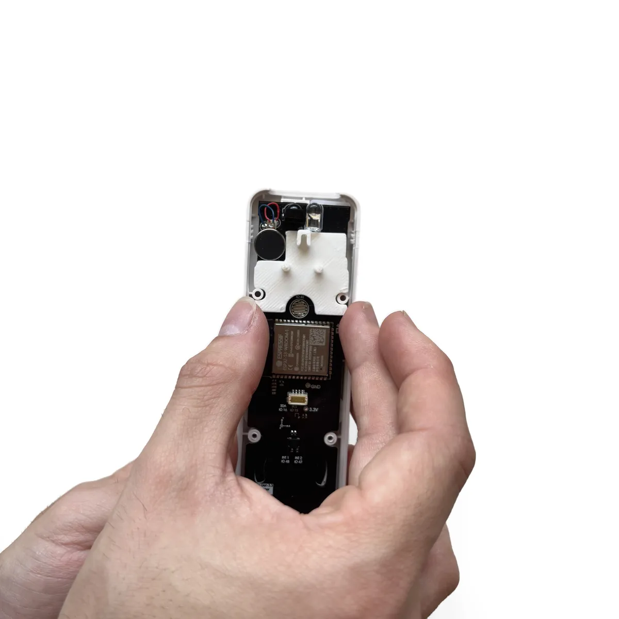
[picture p73: guides/assembly/photos/1516.webp]
Bracket on the board with its two holes circled in yellow over the matching board holes


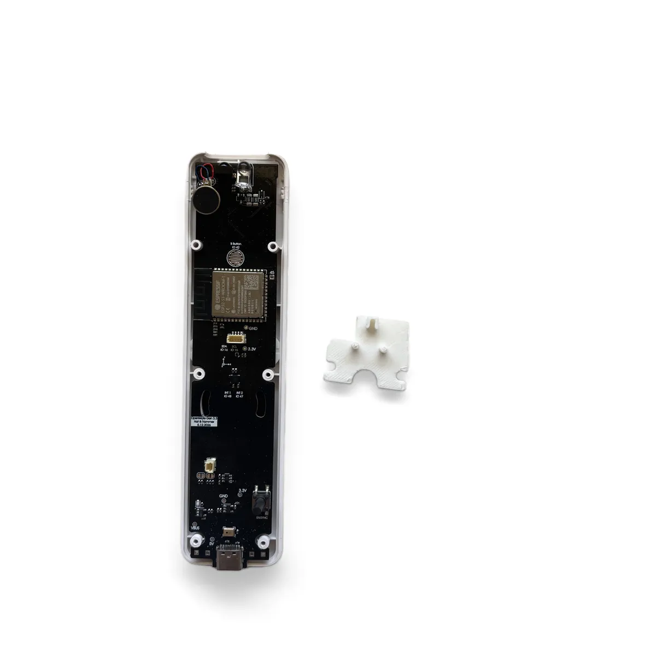
[picture p74: guides/assembly/photos/1515.webp]
White B trigger bracket held above the top end of the board


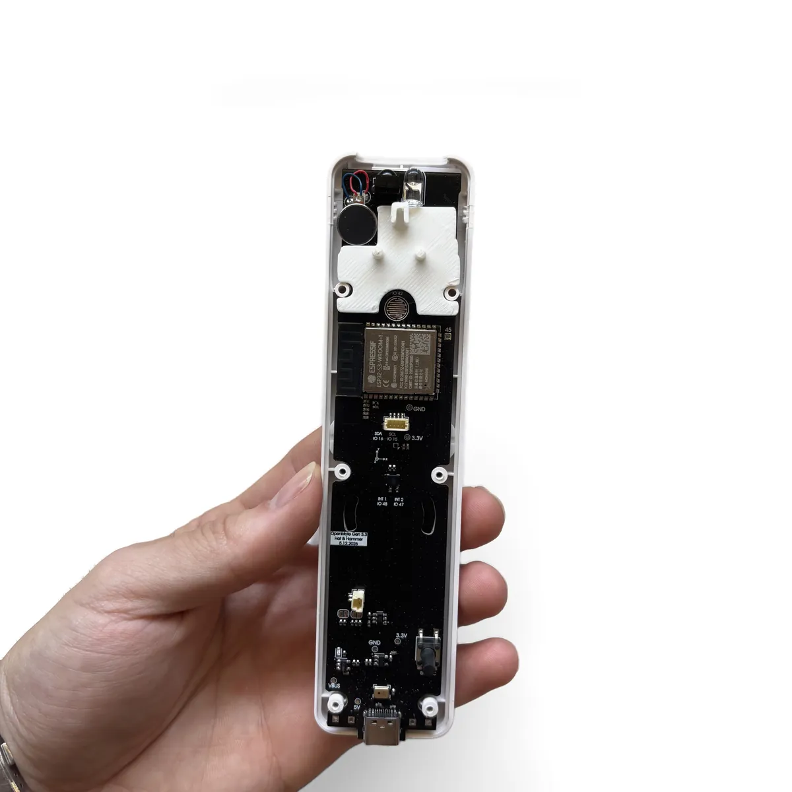
[picture p75: guides/assembly/photos/1517.webp]
Bracket pressed down flat over the top end of the board


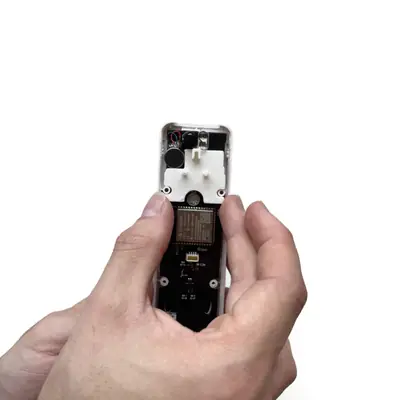
[picture p76: guides/assembly/photos/1516-t.webp]
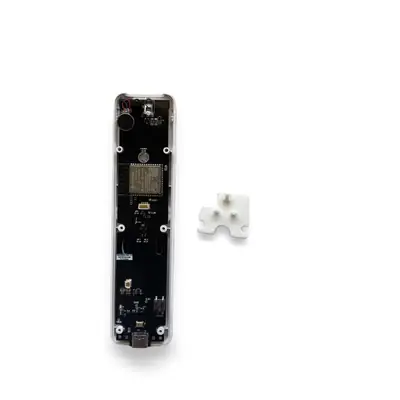
[picture p77: guides/assembly/photos/1515-t.webp]
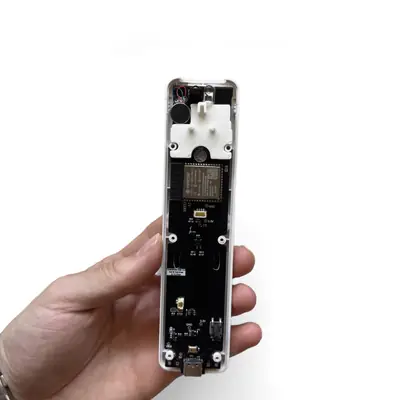
[picture p78: guides/assembly/photos/1517-t.webp]
  

- Take the white B trigger bracket from your kit.
- Place it over the top end of the board, posts facing up, and press it down until it sits flat.
- Alignment: Line up the two holes on the bracket with the two holes on the board, circled in yellow, before you press it down.
- Done, next: Install the B Button →

Step9

### Install the B Button

Mark done

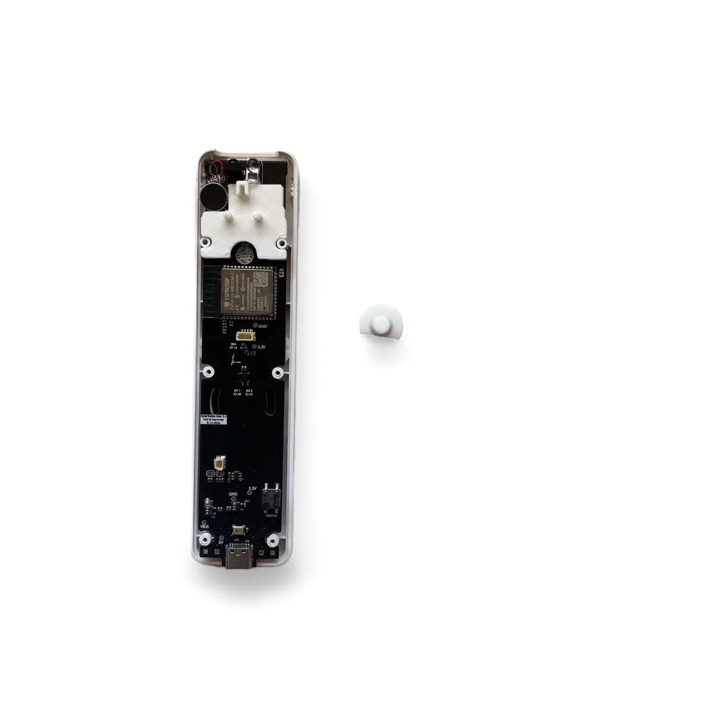
[picture p79: guides/assembly/photos/1518.webp]
B button held with the rounded face up and the half-moon tab pointing toward the ESP32 chip


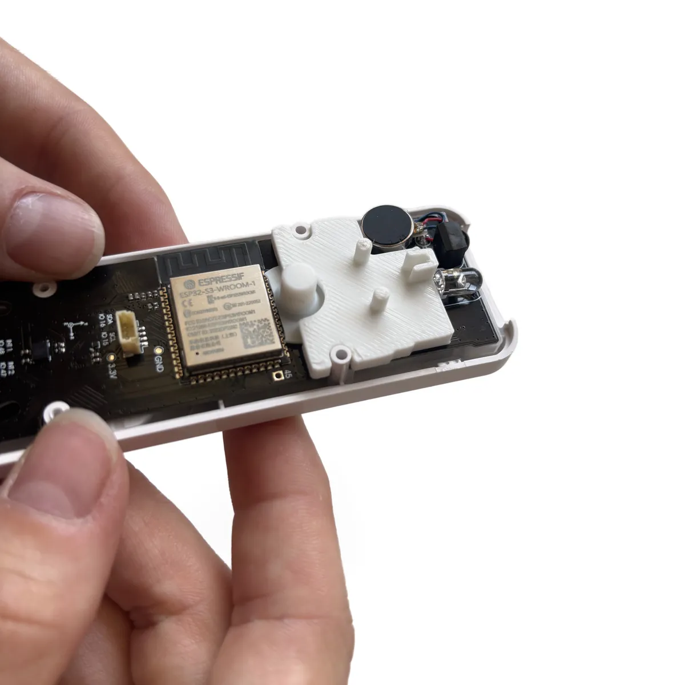
[picture p80: guides/assembly/photos/1519.webp]
B button dropped into the round opening on the bracket, sitting flush


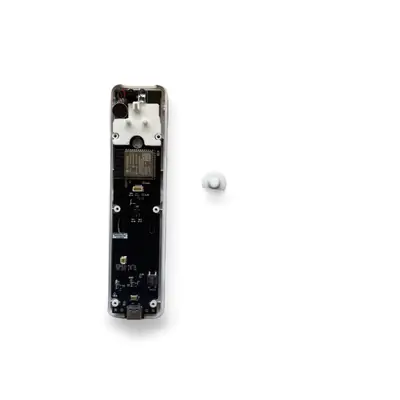
[picture p81: guides/assembly/photos/1518-t.webp]
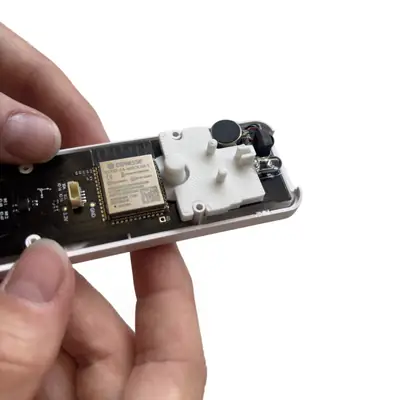
[picture p82: guides/assembly/photos/1519-t.webp]
 

- Hold the B button with the rounded button face pointing up, away from the board.
- Turn it so the half-moon flange points toward the ESP32 chip, away from the trigger end of the remote.
- Drop it into the round opening on the bracket so it sits flush.
- Done, next: Insert the 3D Printed Port Cover →

Step10

### Insert the 3D Printed Port Cover

Mark done

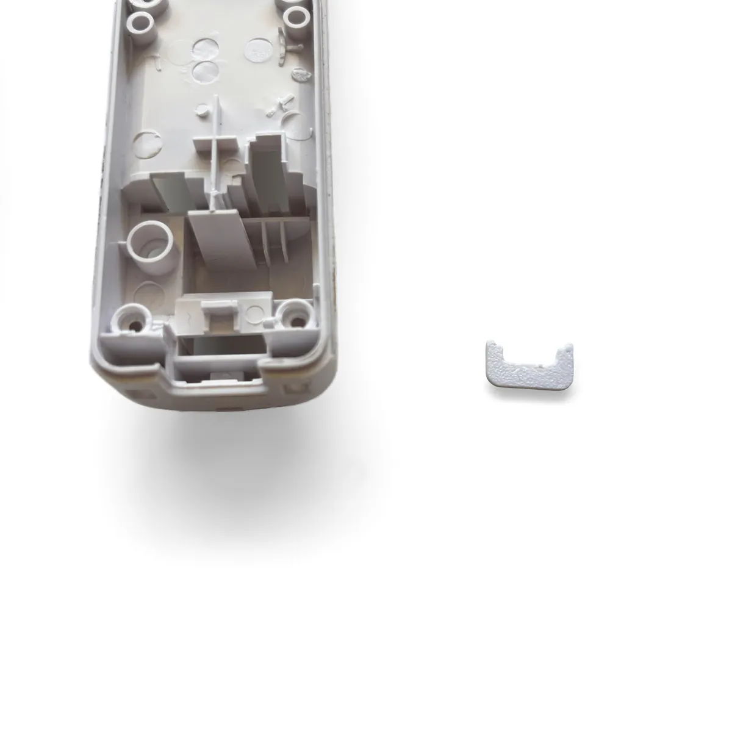
[picture p83: guides/assembly/photos/1521.webp]
Small 3D printed port cover held next to the opening at the bottom end of the bottom shell


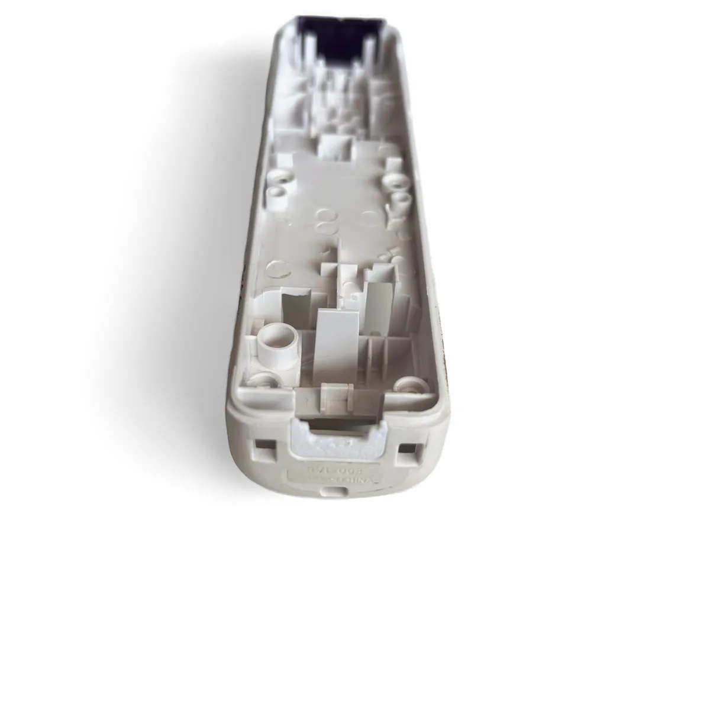
[picture p84: guides/assembly/photos/1522.webp]
Bottom shell end with the port cover in place, the gap around the USB-C port filled


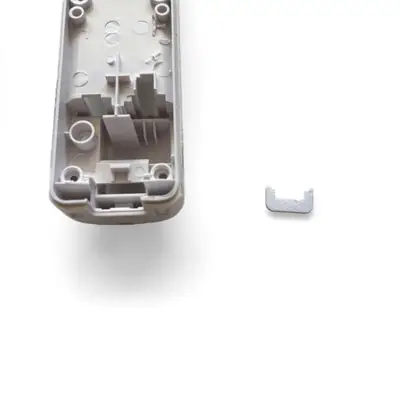
[picture p85: guides/assembly/photos/1521-t.webp]
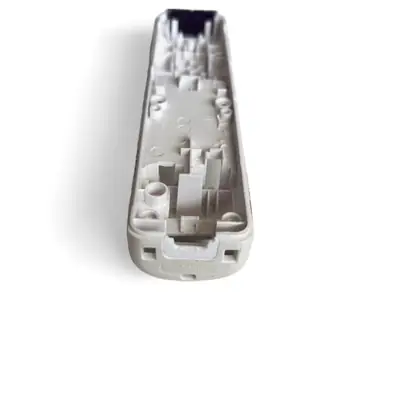
[picture p86: guides/assembly/photos/1522-t.webp]
 

- Take the 3D printed port cover and press it into the opening at the bottom end of the bottom shell.
- The cover fills the gap around the USB-C port so the end of the remote looks clean.
- Note: No printer? Download the STL and order it from any print service.
- Download the port cover STL
- Done, next: Close the Shell →

Step11

### Close the Shell

Mark done

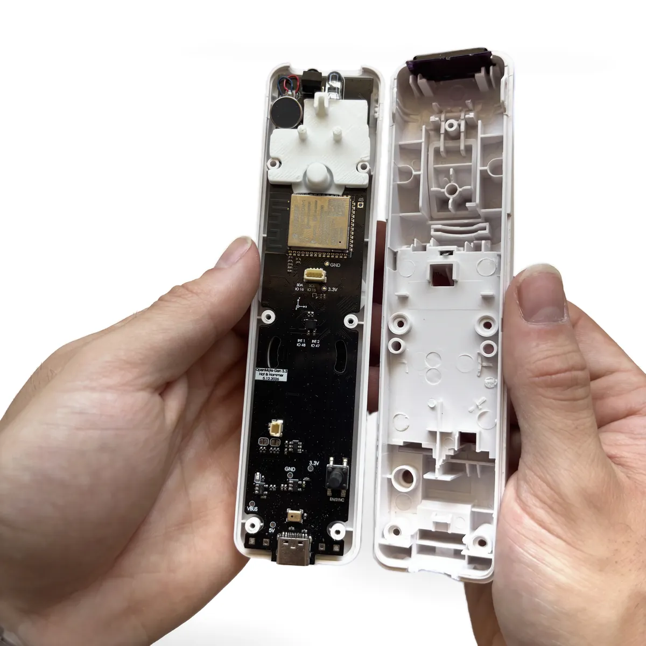
[picture p87: guides/assembly/photos/1523.webp]
Bottom shell lowered onto the top shell with the reset button hole circled in yellow and a line to the reset button on the board


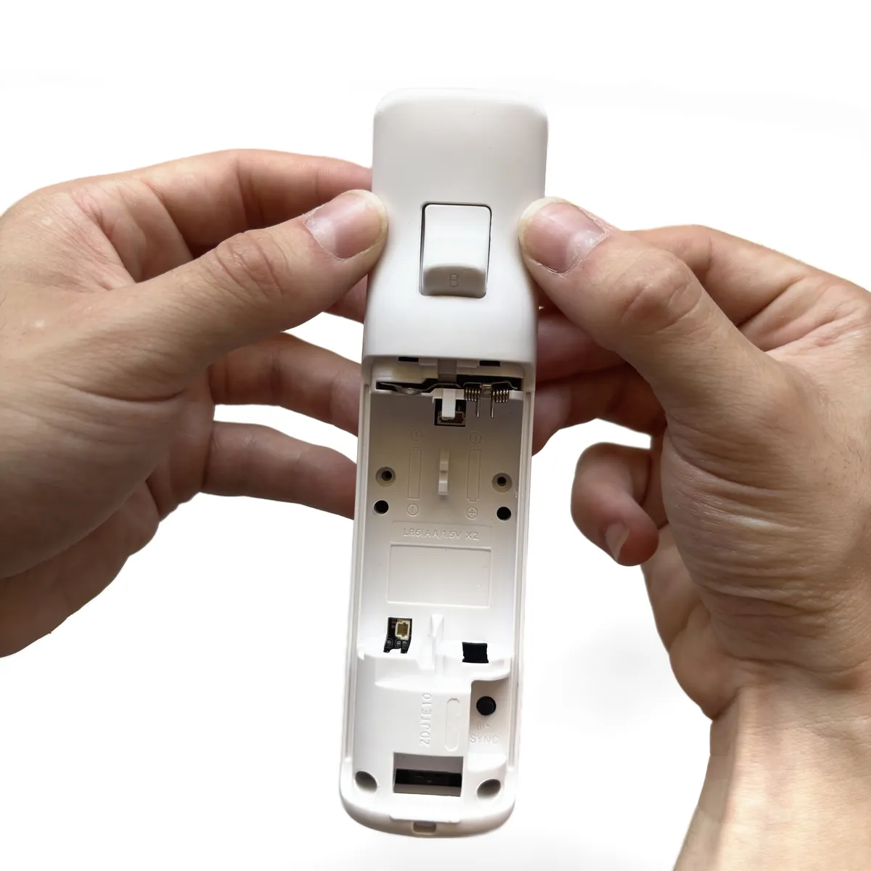
[picture p88: guides/assembly/photos/1525.webp]
Shells brought together starting at the trigger end


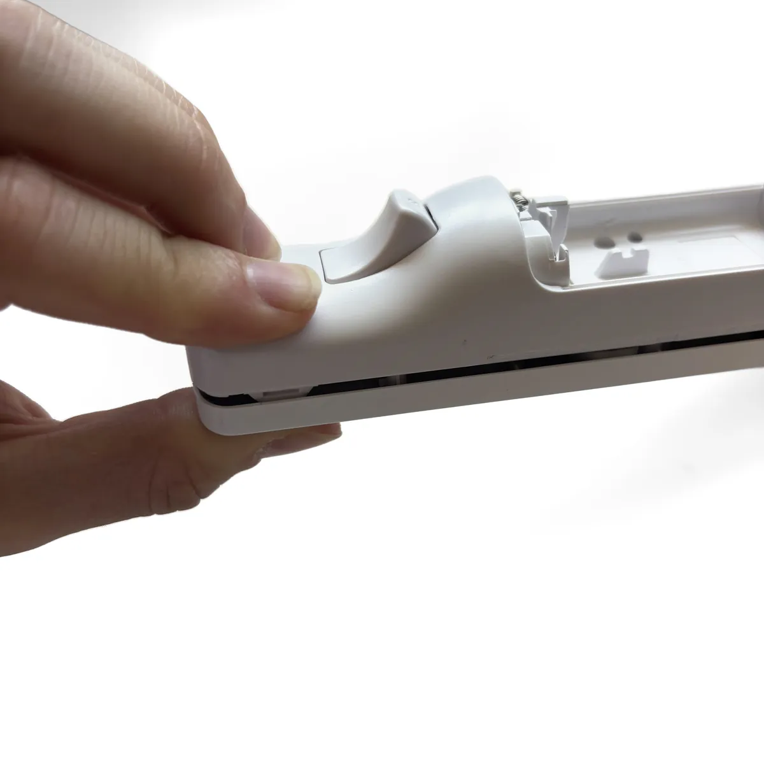
[picture p89: guides/assembly/photos/1527.webp]
Thumbs squeezing the shells shut at the top end, one clip at a time


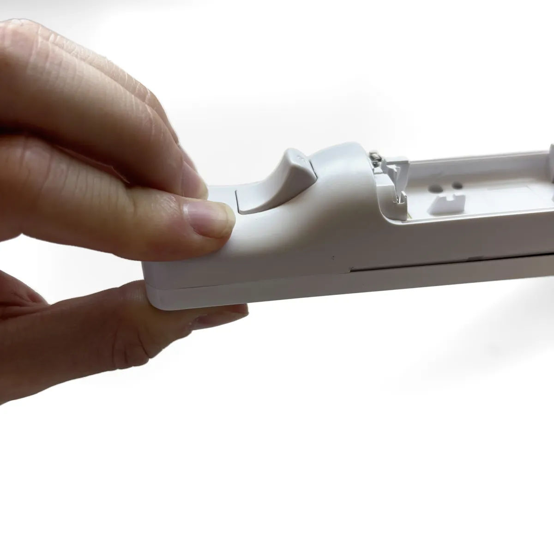
[picture p90: guides/assembly/photos/1528.webp]
Seam closed along one side of the remote


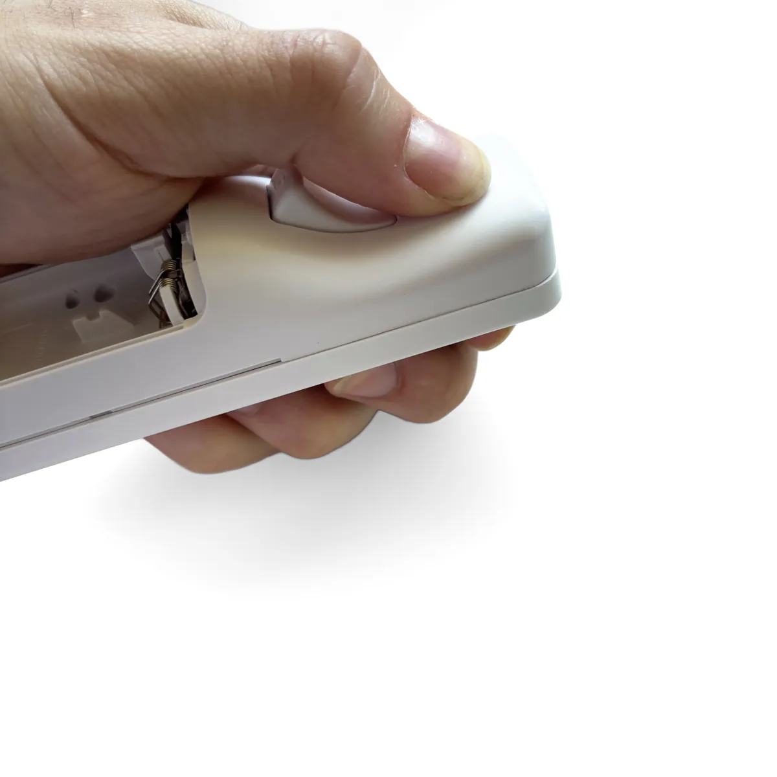
[picture p91: guides/assembly/photos/1526.webp]
Closed remote with the seam flush all the way around


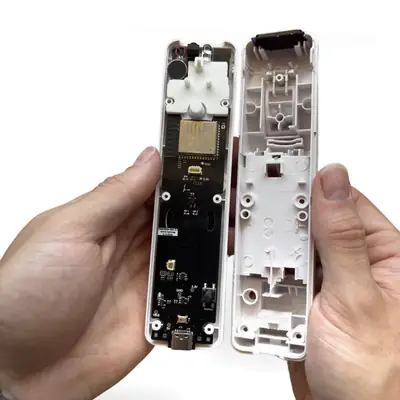
[picture p92: guides/assembly/photos/1523-t.webp]
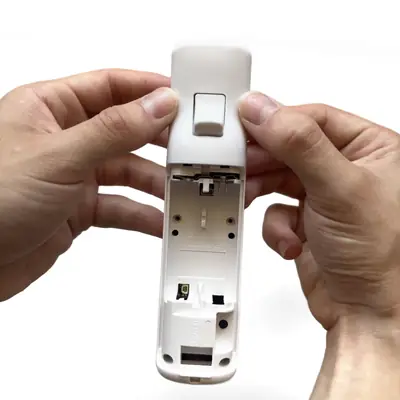
[picture p93: guides/assembly/photos/1525-t.webp]
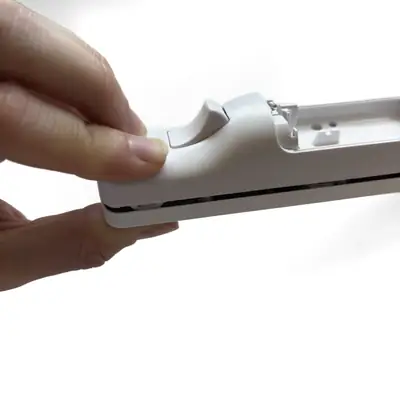
[picture p94: guides/assembly/photos/1527-t.webp]
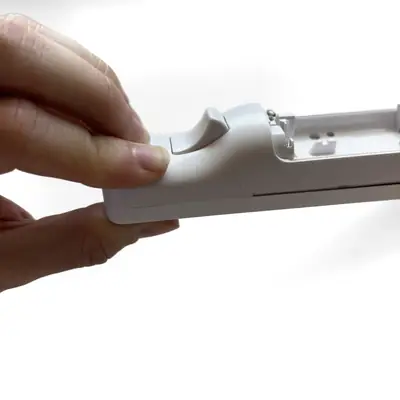
[picture p95: guides/assembly/photos/1528-t.webp]
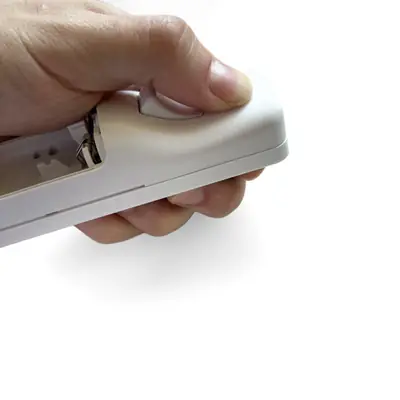
[picture p96: guides/assembly/photos/1526-t.webp]
    

- Lower the bottom shell onto the top shell, starting at the trigger end.
- Check that the B button is seated on top of its membrane button before you close the shell.
- Alignment: The reset button on the board fits through the round hole in the bottom shell, circled in yellow. Line them up as you close the shell.
- Squeeze the top of the remote where the two clips are, one clip at a time, until each one snaps shut.
- Caution: Don’t force it. If the seam won’t close, open the shell and check the bracket and B button are seated.
- Done, next: Reinstall the Screws →

Step12

### Reinstall the Screws

Mark done

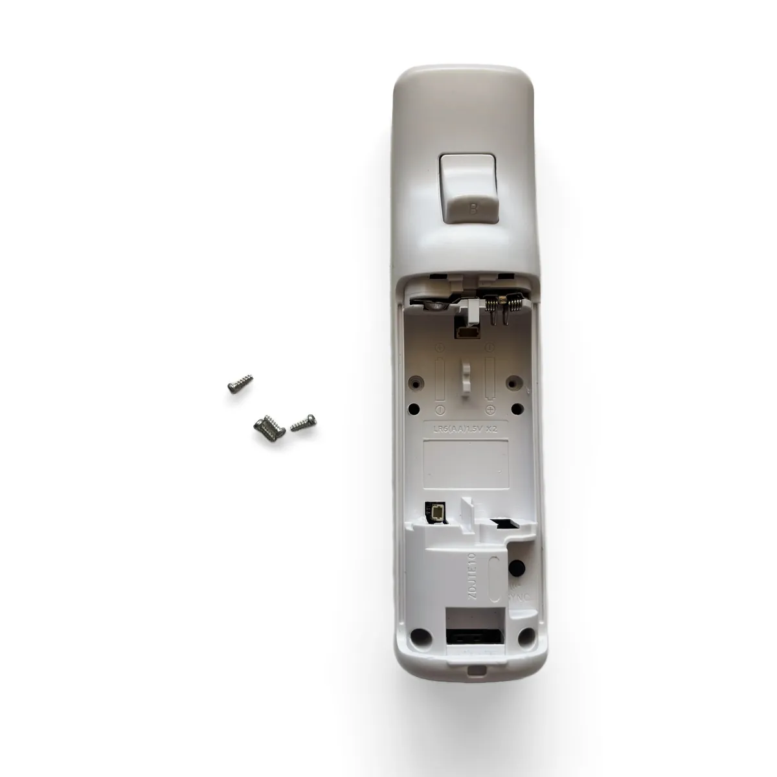
[picture p97: guides/assembly/photos/1529.webp]
Reassembled remote face down with the four screw holes circled in red and the screws beside it


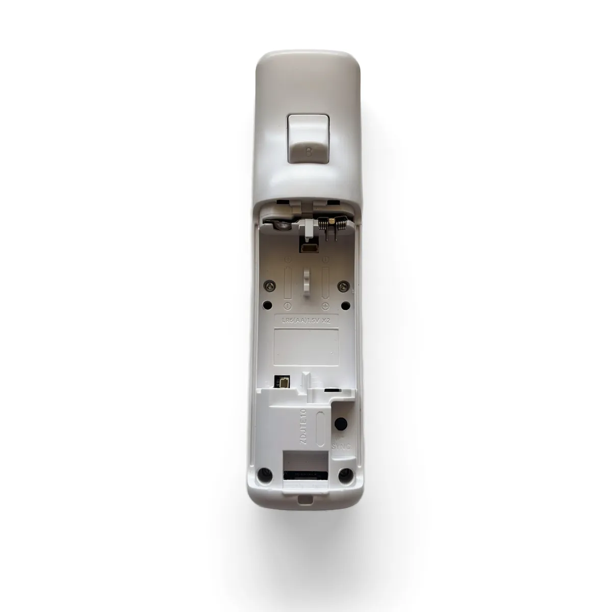
[picture p98: guides/assembly/photos/1530.webp]
Screwdriver reinstalling one of the four tri-wing screws, holes circled in red


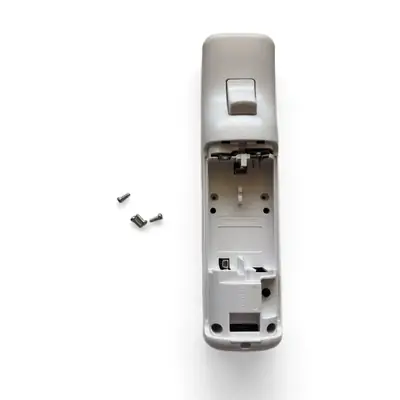
[picture p99: guides/assembly/photos/1529-t.webp]
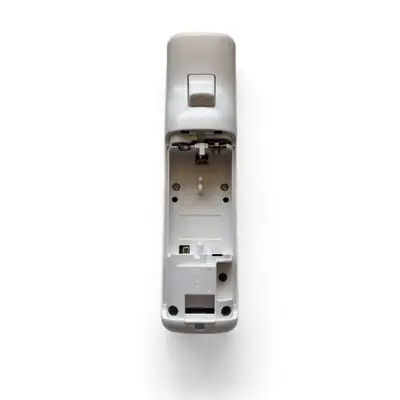
[picture p100: guides/assembly/photos/1530-t.webp]
 

- Reinstall the four tri-wing screws you removed in Step 2, in the locations circled.
- Caution: Stop as soon as each screw is snug. Overtightening can strip the plastic posts.
- Done, next: Connect the Battery →

Step13

### Connect the Battery

Mark done

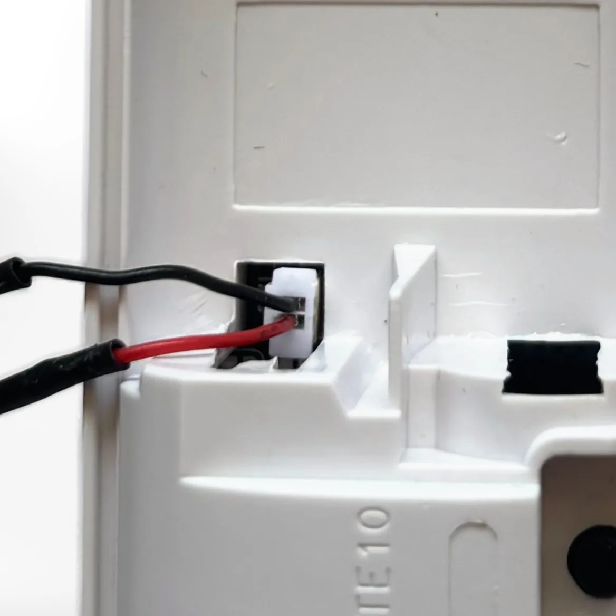
[picture p101: guides/assembly/photos/1531_zoom.webp]
Close-up of the battery socket. The black negative wire goes in the top pin, marked Negative, and the red positive wire in the bottom pin, marked Positive
 Negative −Positive +

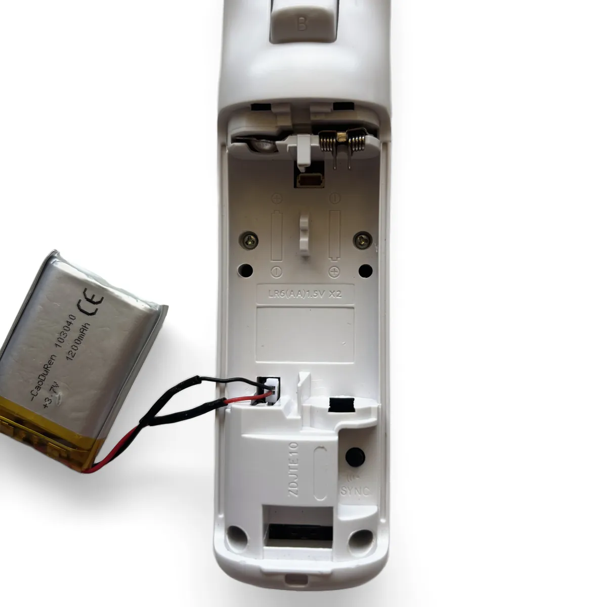
[picture p102: guides/assembly/photos/1531.webp]
Battery connector being plugged into the socket at the bottom of the battery bay, with Negative on top and Positive below marked by arrows
 Negative −Positive +

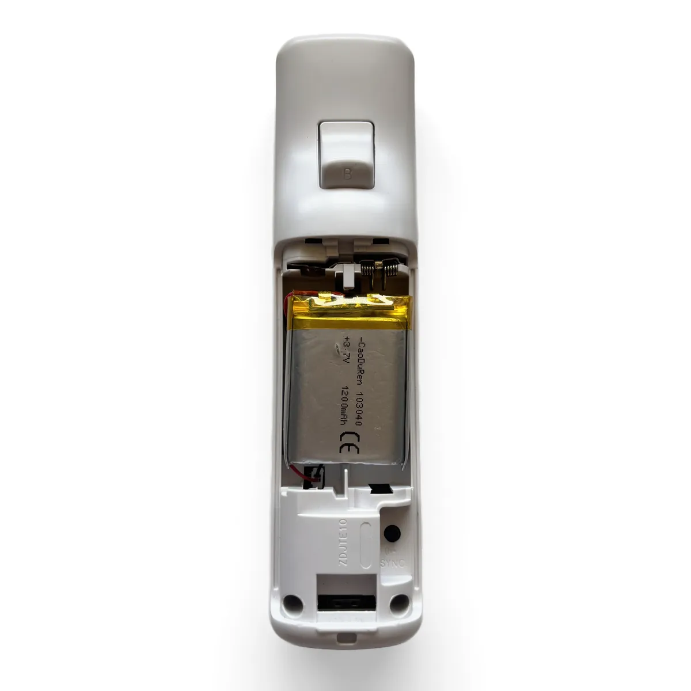
[picture p103: guides/assembly/photos/1532.webp]
Battery set into the bay with the wires tucked to the side


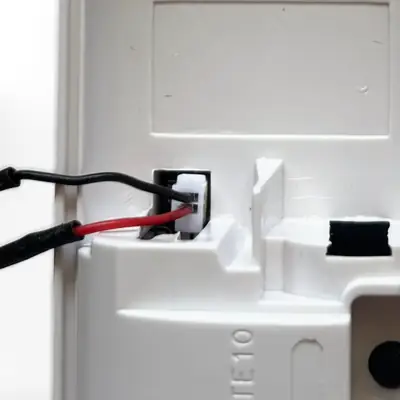
[picture p104: guides/assembly/photos/1531_zoom-t.webp]
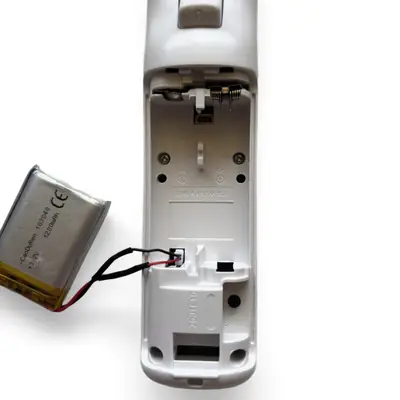
[picture p105: guides/assembly/photos/1531-t.webp]
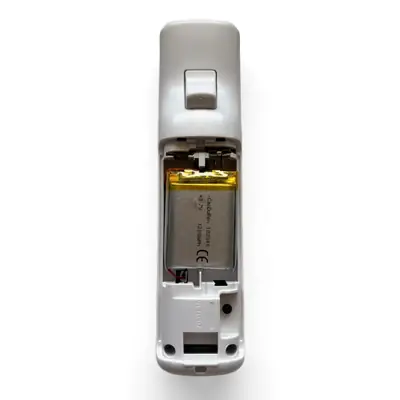
[picture p106: guides/assembly/photos/1532-t.webp]
  

- Plug the battery connector into the socket at the bottom of the battery bay.
- Negative (black wire) goes on top. Positive (red wire) goes on the bottom.
- Caution: Don’t install the battery backwards. Match the wires to the Negative and Positive labels in the photo before you plug it in. Backwards will damage the board.
- Tuck the wires to the side and set the battery into the bay.
- Caution: Never puncture, bend or crush a lithium battery.
- Done, next: Replace the Battery Cover →

Step14

### Replace the Battery Cover

Mark done

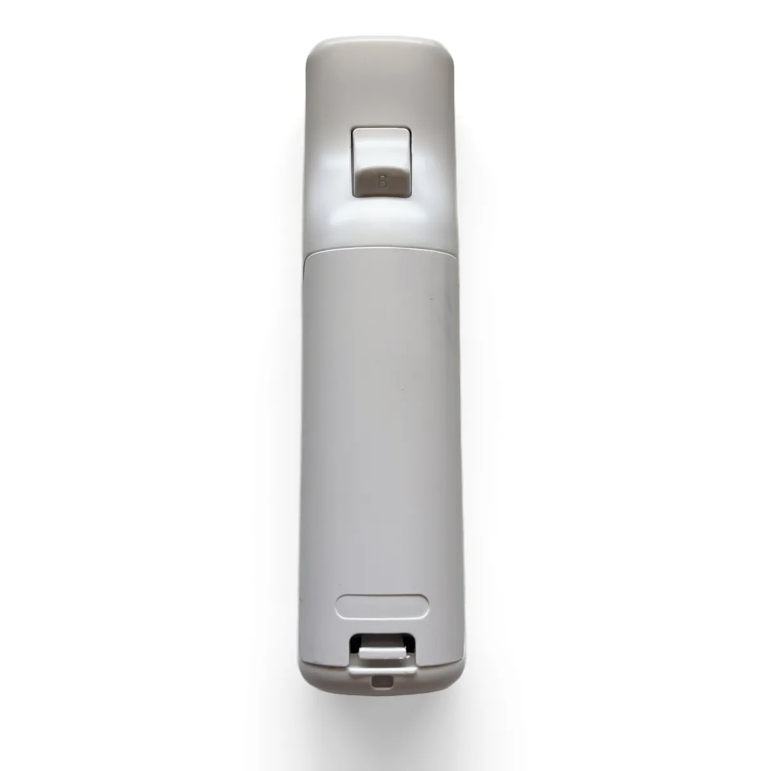
[picture p107: guides/assembly/photos/1533.webp]
Battery cover sliding back on


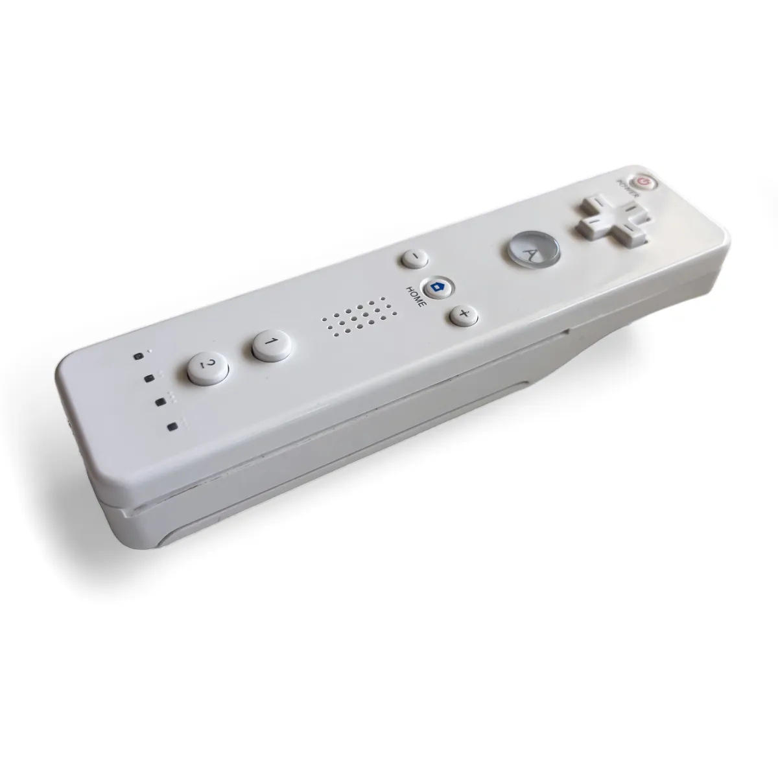
[picture p108: guides/assembly/photos/1535.webp]
Finished remote, back side up, with the battery cover clicked shut


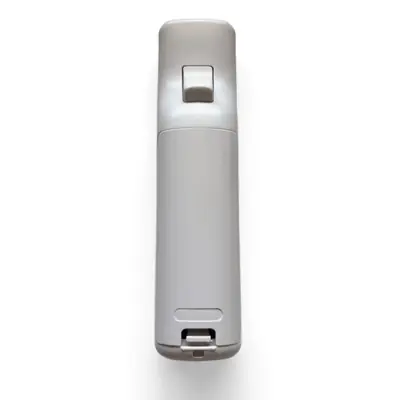
[picture p109: guides/assembly/photos/1533-t.webp]
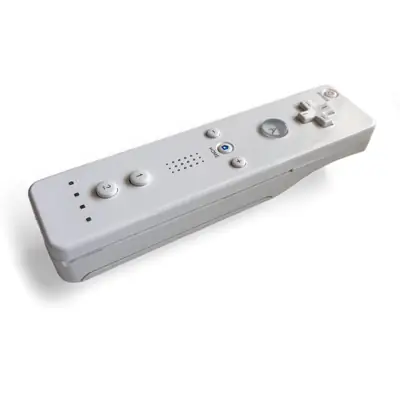
[picture p110: guides/assembly/photos/1535-t.webp]
 

- Slide the battery cover back on until it clicks.
- Your OpenMote is ready. Charge it over USB-C before first use.
- Done, finish →

Conclusion

## Done. Your OpenMote is in.

Nice work. Charge it over USB-C before first use. Setup and programming guides are next. Until they are up, ask in the Discord.

Join the Discord (https://openmote.io/discord)Back to Step 1

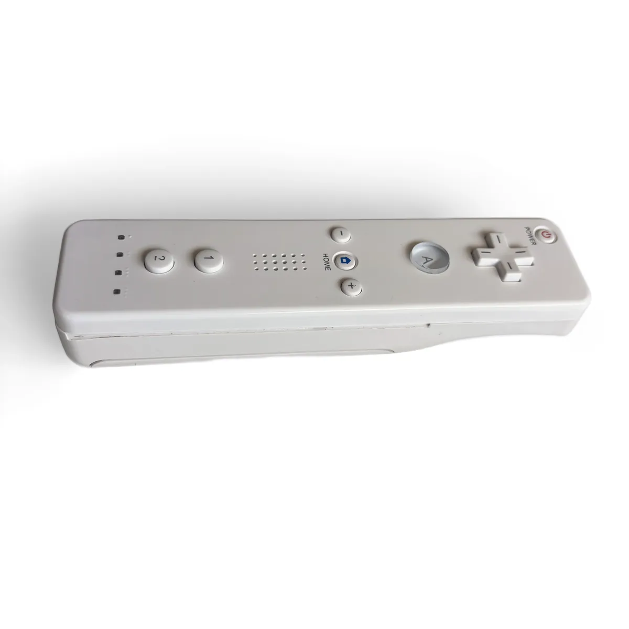
[picture p111: guides/assembly/photos/1534.webp]
A closed Wii Remote with OpenMote inside, button side up. From the outside it looks like the original.


© 2026 Hat & Hammer · Los Angeles

Wii and Wii Remote are trademarks of Nintendo. OpenMote is an independent product from Hat & Hammer and is not affiliated with, endorsed by, or sponsored by Nintendo.

You were partway through.Resume✕
