SamsonTaxon/openmote-landing/guides/assembly/og.jpg

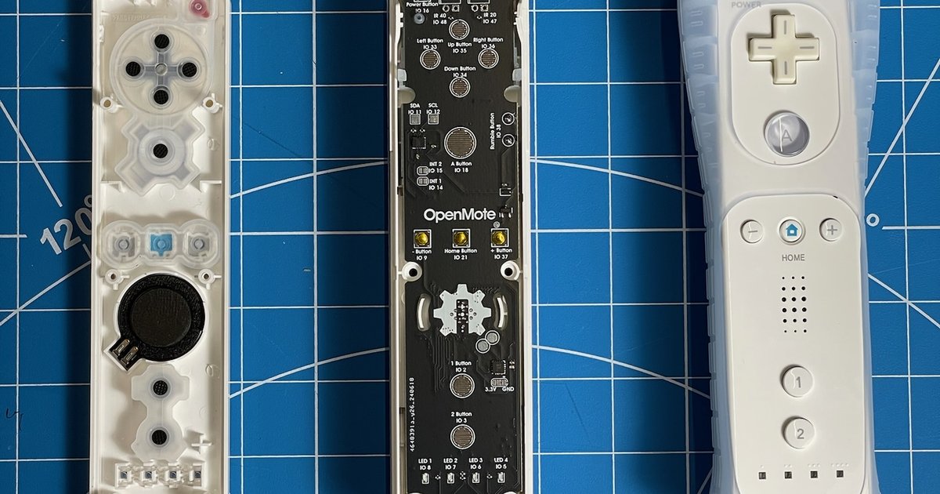
guides/assembly/og.jpg
