SamsonTaxon/openmote-landing/guides/assembly/photos/1520-t.webp

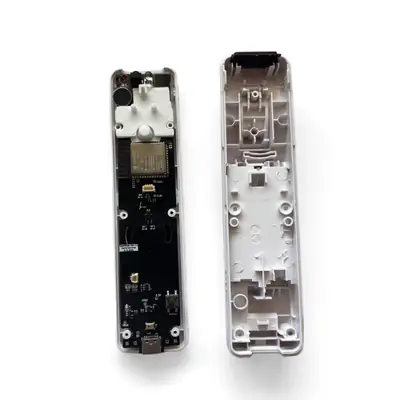
guides/assembly/photos/1520-t.webp
