SamsonTaxon/openmote-landing/some assets/Design History.png

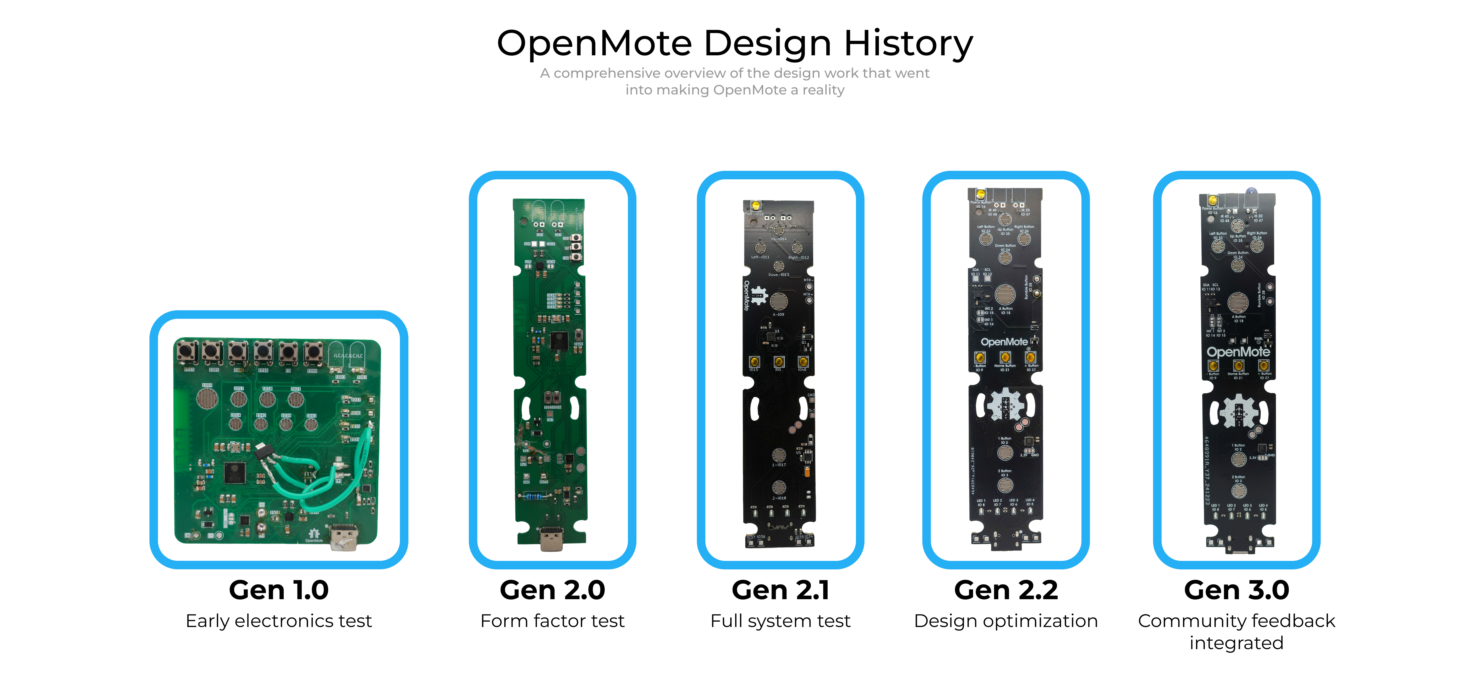
some assets/Design History.png
