SamsonTaxon/openmote-landing/conformity/OpenMote-EU-UK-Declaration-of-Conformity.pdf

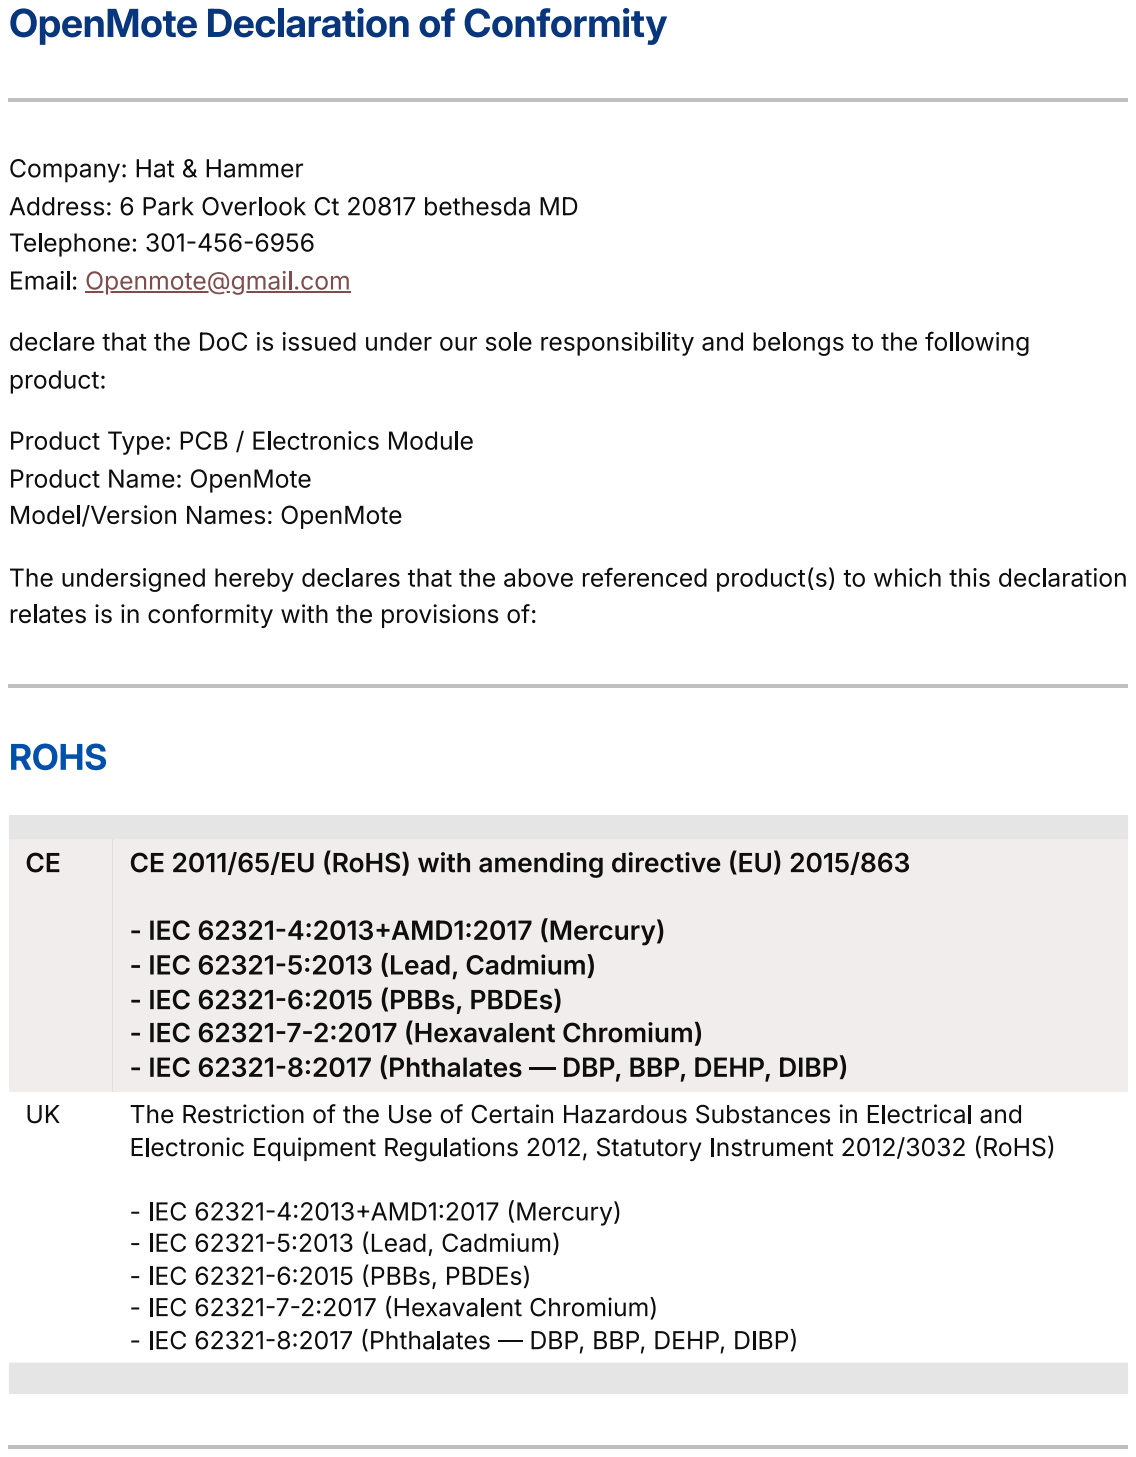
[picture p115: page 1]

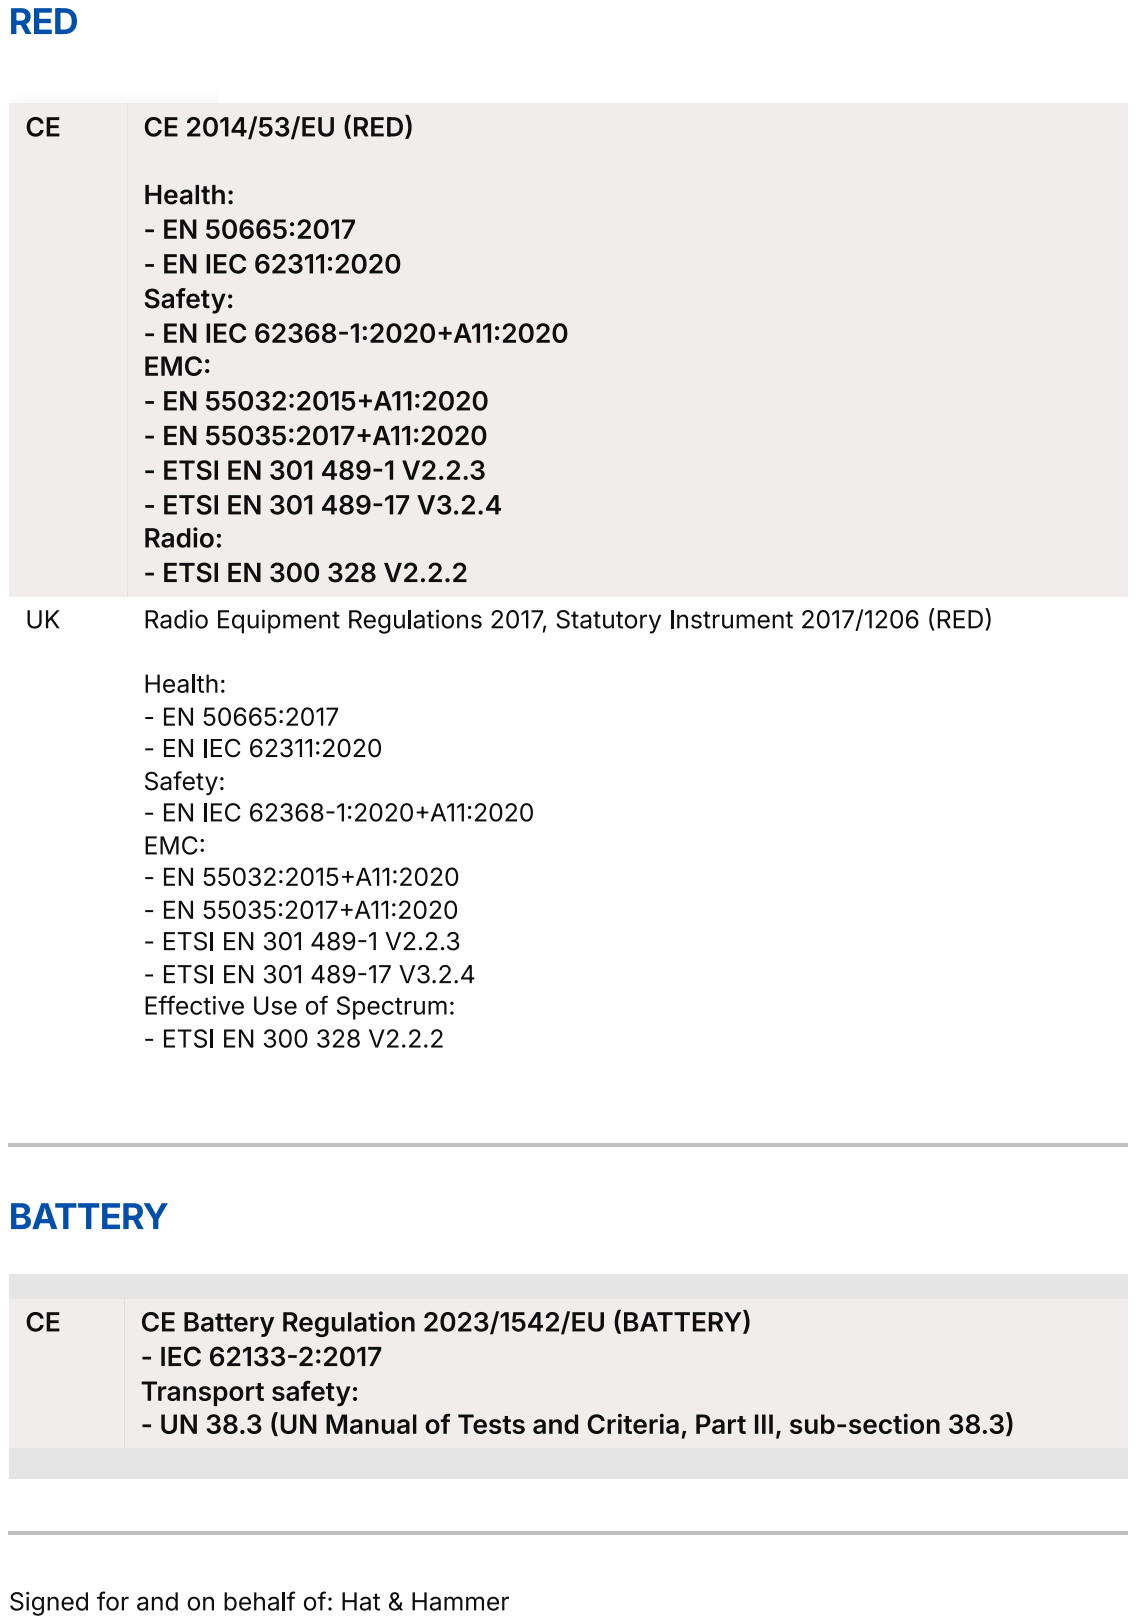
[picture p116: page 2]

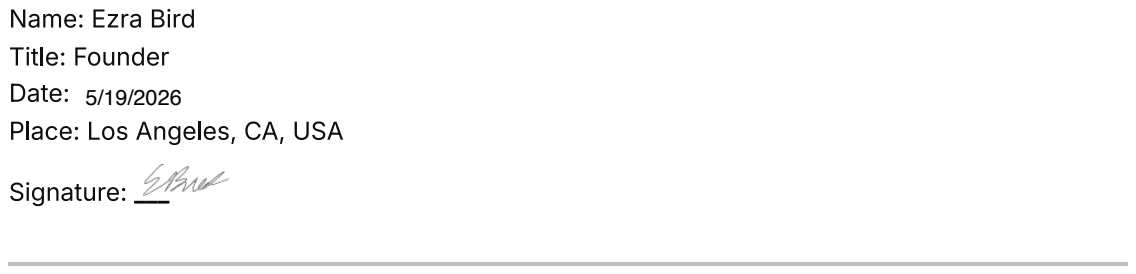
[picture p117: page 3]
