SamsonTaxon/openmote-landing/(commit log)

2026-01-30 Initial commit: OpenMote landing page
2026-08-04 Add private preview of redesigned landing page at /preview-b7k4x9
    Not linked from anywhere, noindex via meta + X-Robots-Tag. Existing site
    untouched. Performance-optimized (45% lighter, sub-9s full load on slow 3G)
    with pixel-verified visual fidelity to the approved design. Loops waitlist
    form verified live end to end.
    Claude-Session: https://claude.ai/code/session_01LgQz7Uw7vJmJ8tamh912kh
2026-08-04 Preview fixes: scroll capture bug, modal click-blocker, spacing rhythm
    Wheel scrolling was dead over page content: overscroll-behavior-y:none on
    body plus overflow-x:hidden on html turned body into a zero-height scroll
    container that swallowed wheel events; property moved to the root where it
    belongs. Closed desktop modal was invisibly intercepting clicks on the
    finale waitlist and Crowd Supply CTAs; now visibility:hidden and
    pointer-events:none while closed, zero pixels changed. Tightened the gaps
    around the scroll-cue dots and above the NOW RUNNING card per owner review.
    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
2026-08-04 Bake owner-tuned spacing, fix code-cue gap at source, 2x2 platform grid
    Per-instance scroll-cue paddings from the live tuner saves (677px and
    1382px sets), apps intro gap 3px, code cue gap cut to a uniform 14px by
    reducing the apps band bottom padding, and the platform logo row now
    renders 4 across or a centered 2x2, never 3 plus 1, at every width.
    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
2026-08-04 Hero card, owner tweaks, and de-Claude structural pass on preview page
    - Desktop-only contained hero card with tuned duo geometry, glow, scroll cue
    - 32px cursors to shrink Chrome bottom-edge suppression band
    - Footer: Instagram icon link, shrunk photo credit (contrast fixed)
    - Board card stat wrap through tablet, smaller stat floor on phones
    - Copy: open-sourced before units ship; campaign-launch bar line
    - Reveal system curated 52 -> 9 animated elements (3 kept moments)
    - Eyebrows neutral, spec squares removed, lead spec card dominant
    - Bar elevation raised, sheet shadow re-derived, card grays off neutral ladder
    - Audit fixes: focus-visible rings, hover gating, select/pointer-events hygien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
2026-08-04 Replace head-on remote with owned asset, drop attribution
    - product-02 swapped for Samson's own generated render (3x resolution,
    8.6KB vs 6.6KB, identical 85x300 rendered footprint, zero layout shift)
    - Footer photo credit removed: no CC-licensed asset remains on the page
    - Fix .f-ig rules that were swallowed into the @media(hover:hover) block,
    so the Instagram icon lays out correctly on touch devices
    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
2026-08-05 Fix hero grouping, yellow remotes, heading decks, arc, sparse smart scene, stacked rows
    - White-balance all remote imagery: hero remotes were +28 R-over-B (yellow),
    now neutral and matched to the centre remote. Selective neutralization keeps
    the blue HOME, red POWER and green PCB intact.
    - Hero card: remotes and copy now anchor to the card centre line with one shared
    gap instead of hugging the outer edges; step-down below 1340px.
    - Delete the deck line under every section heading.
    - Arced headline replaced with straight type (raised above the scene fades).
    - Smart-home scene: ecosystem marks sized to their labels, no longer tiny.
    - Three-stacked demo rows: row 1 dominant, row 2 mirrore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
2026-08-05 Add light/white variant at its own private path
    Full light theme built from the current dark file so it inherits the white
    remotes, regrouped hero, reworked demo rows and normalized icons. Markup and
    script are byte-identical to the dark page apart from theme-color; only the
    style block differs. Spec cards inverted to ink, photography shadows retuned
    for a light ground, every force-inverted mark fixed, blue kept at #25AFF4
    with a darker token for blue-as-text.
    noindex headers extended to the new path.
    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
2026-08-05 Hi-res hero cutouts, restore animation sequences, hide demo section, hero on page grid
    - Re-cut both hero remotes from the 1536x2730 original instead of the
    675x1200 web copy: now 1400px tall, white-balanced and de-matted.
    - Restore sequence phase offsets I destroyed by grid-snapping them
    (scroll cue dots had collapsed to 0/0/0.75, ripple rings to clumps).
    Durations stay on the shared beat; phases are evenly divided again.
    - Hide the three-demo section for now, markup retained.
    - Hero card on the same max-width:90rem + var(--gut) grid as content cards.
    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
2026-08-05 Neutralize the warm environment in the hero photograph
    The remotes were already corrected but the countertop and brick were left
    piss-yellow: the earlier pass deliberately spared saturated pixels so it only
    neutralized the plastic. Grey-world balance across the whole frame plus a
    feathered desaturation of the 15-75 degree warm hues kills the yellow
    surface without touching the blue HOME button or the green PCB.
    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
2026-08-05 Deploy the day's work: new logo, hero remotes, saved layout, DIY card
    - Samson's new logo (new tagline) in both versions
    - New hero remote cutouts from his colour-corrected files, plus the new
    product-03; all de-matted so no jagged edges on white
    - His saved pill/icon positions, slider values and per-set dot spacing baked in
    - DIY card: solid brand blue, white copy, white wireless waves, ghost icons on
    one flat colour so overlapping strokes stop compounding
    - Hero bob amplitude raised (9/6px -> 22/16px) with a slight roll
    - DIY remote nudged left and enlarged
    - Repair CSS broken by a bake regex that mishandled nested parens
    Claude-Session: https://claude.ai/code/session_01LgQz7Uw7vJmJ8t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
2026-08-05 Ship the light version to /preview-b7k4x9/
    The light build becomes the preview page. Includes the new logo and footer
    lockup, new hero remote cutouts and product-03, Samson's saved pill/icon
    positions, slider values and per-set dot spacing, the solid-blue DIY card
    with white waves and flat-colour ghost icons, stronger hero bob, and the
    right-angled connector path.
    The drag/tuning panel is injected by the local dev server only and has never
    been part of the file. Dark version remains in history at 2440fc6.
    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
2026-08-05 Light build with mobile layout regressions fixed
    Restores the light build and repairs what I broke on mobile. Measured every
    major element at 390px against the pre-regression build: now zero differences.
    Three causes, all mine, all from desktop-only tuning leaking into mobile:
    - baked slider values replaced responsive clamp() defaults with fixed px, so
    phone-sized elements got desktop dimensions; defaults restored and the tuned
    numbers scoped to >=1024px
    - the DIY remote's -24px nudge sat in the base default instead of the desktop
    block, shifting it 24px left on phones
    - the baked per-set dot spacing, including a -91px pull, applied at every
    width, collapsing the code section by 95p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
2026-08-06 Anchor scene labels to the remote; fix drift, disappearing, spacing and stacking
    - Labels are now positioned as a percentage of a box that IS the remote, not
    the scene. Widening the window can no longer spread them: measured drift
    across 768-1920px is 0-13px, was hundreds.
    - Labels hold still while the remote bobs (remote 33.6px travel, labels 0px).
    - Fixed labels vanishing below 1024px: var(--remote-h) had no fallback, so the
    whole left/top declaration was invalid and elements lost their position.
    - Fixed three icon divs whose closing tags I had cut, nesting them inside each
    other; that was the mass overlap.
    - Remote reaches 660px only from 1180px, where the scene is tall enough; at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
2026-08-06 Update the shared remote cutout (app switcher + waving remote)
    product-02 replaced with Samson's newer render: 1965x6906 source, installed
    at 398x1400 (was 256x900). Shell measures -3.6 red-over-blue, neutral white.
    Edge de-matted and antialiased so it stays clean on the light background.
    It renders up to 340px tall, so 1400px of source gives real retina headroom
    where 900px was already being upscaled.
    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
2026-08-06 Fix the mobile Join Waitlist bar: white-on-white and premature appearance
    - My iOS backdrop-filter fix forced the bar's background to white while its
    text and button stayed white, making it unreadable. The backdrop-filter was
    the only iOS problem; the brand-blue surface is restored.
    - The bar now requires a real scroll past the hero, not just the hero leaving
    the viewport. On iOS the visual viewport shrinks as the toolbars collapse,
    so a 100svh hero can exit sooner than it appears to.
    Verified on mobile: hidden at top, hidden mid-hero, visible past the hero,
    hidden near the end. Blue background, white text, white button.
    Claude-Session: https://claude.ai/code/session_01LgQz7Uw7vJmJ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
2026-08-06 Mobile CTA: copy the live site instead of the floating bar
    openmote.io has no bottom bar at all - confirmed, zero occurrences. Its nav is
    fixed at the top, always visible, background fading in after 50px. That is why
    it has none of these problems: there is nothing to appear, mistime or drift.
    Below 1024px the floating bar is now hidden and the nav is pinned exactly like
    the live site, with the Join Waitlist button always reachable. Desktop keeps
    the bar and the hide-on-scroll nav.
    Verified at five scroll positions: nav fixed at top:0 and visible throughout,
    join button present, bottom bar display:none.
    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
2026-08-06 Preview bug sweep: scroll feel, tablet header, board fade, marquee, dead CSS
    - Restore native iOS scroll: drop overscroll-behavior-y:none from the root
    - Fix tablet 768-1023: header logo/button now invert over the blue hero
    - Board PCB photo: fade rides the image (mask), fixing the mobile hard cut
    and the desktop dark smear at the card edge
    - Ripple rings hit zero alpha before the scene clip, killing the 1px
    scroll seams at the top and bottom edges
    - Marquee strips load eagerly so the loop distance never re-bases mid-run
    - One rAF-batched scroll handler replaces four listeners; connector only
    redraws on real width changes (iOS toolbar resizes no longer thrash)
    - Escape only closes the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
2026-08-06 Defuse the iOS layer bomb: static ripple rings on touch devices
    Each pulsing ring group is its own compositor layer up to ~2300px square.
    Eight of them overcommit the iPhone GPU and Safari starts dropping
    unrelated layers mid-scroll, which is the random blink-out of text,
    images and whole sections on the phone (never on desktop). Rings render
    static at the pulse midpoint on touch devices; desktop keeps the pulse.
    Marquee layers now commit only while the band is near the viewport.
    Adds a ?calm flag that kills every animation for on-device A/B testing.
2026-08-06 Cut mobile repaint cost: right-size every image, rasterize heavy vectors, lighter shadows on touch
    The fast-scroll blink-outs are Safari evicting offscreen tiles and
    repainting them late because tiles were expensive: images up to 9x their
    displayed size (product-03 was 1088x3790 for a 400px slot), two vector
    files re-rasterized on every repaint (153KB devkit schematic, 92KB
    CircuitPython mark), and stacked wide Gaussian drop-shadows.
    - All flagged images resized to 2-3x displayed size (halves image payload,
    cuts ~20MB of decoded bitmap memory)
    - esp32-devkitc and circuitpython render as WebP rasters
    - Touch devices get one tight drop-shadow per cutout instead of stacked blurs
    - Ring pulse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
2026-08-07 Ship the redesign: new homepage, survey flow, legacy archive, and the full SEO/AEO layer
    Schema @graph (two PreOrder products, FAQPage mirrored by a visible
    15-question FAQ), rebuilt head and OG images, AI-crawler robots.txt,
    llms.txt, IndexNow key, footer section nav, and the nominative-use Wii
    compatibility wording with its trademark attribution line.
2026-08-10 Repair plus-addressed emails arriving from newsletter merge tags
    A merge tag inserts the address raw, so the plus in you+tag@gmail.com
    decodes as a space and the answer fails validation. A space is never
    legal in an address, so restoring the plus is lossless.
2026-08-10 Fix survey copy: drop the build-quantity premise and name the mod use case
    The standalone page claimed we were deciding how many of each to
    build, which is not what a crowdfunding survey does. It now says
    what is true: we are curious which way people would go. The board
    option names modifying a remote you already own.
2026-09-01 Host the EU/UK Declaration of Conformity at /conformity
    The safety insert's simplified DoC points at openmote.io/conformity, which
    RED Article 10.9 requires to resolve to the full declaration. Page carries
    the signed DoC PDF, the covered directives, and the radio declaration.
    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
2026-09-02 Landing page: launch date September 15 in badge, bar, meta, OG image, schema, llms.txt
    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
2026-09-11 Launch countdown hero: clock to Sept 15 10 AM PT, waitlist button, self-flips to live
    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
2026-09-15 Launch state: headline, shorter button that fits on phones, forward watchers 60s after zero
    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
2026-10-07 Guides: assembly guide at /guides/assembly, guides index, /assembly redirect, sitemap entries
    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
    [port-cover.stl]
2026-10-07 Redirect /assembly/ (trailing slash) to the guide; add a 404 page so unknown paths stop serving a broken homepage
    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
2026-10-07 Assembly guide: drop the unrelated board-next-to-shell photo from step 10
    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
